eleboss/DJI_robomaster_car/README.md

# DJI_robomaster_car 
是为了参加DJI2017 robomaster竞赛中的地面机器人挑战赛而特地写的地面机器人控制程序。  
里头完成了一些例如SPI IIC CAN等总线的进本框架程序并且通过了测试  
进一步的，包含了位置式的串级PID  
还有一些杂资料
