eleboss/DJI_robomaster_car/Solidworks文件/ROBOmaster/底部接夹.SLDPRT

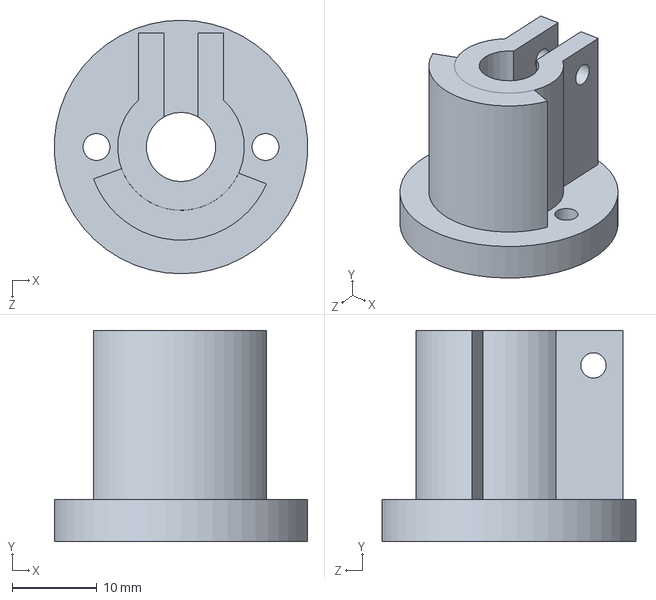
[picture p14: CAD file, 2017-07-21]
Solidworks文件/ROBOmaster/底部接夹.SLDPRT
29.9 x 25.0 x 30.0 mm
