eleboss/DJI_robomaster_car/Solidworks文件/ROBOmaster/holder.SLDPRT

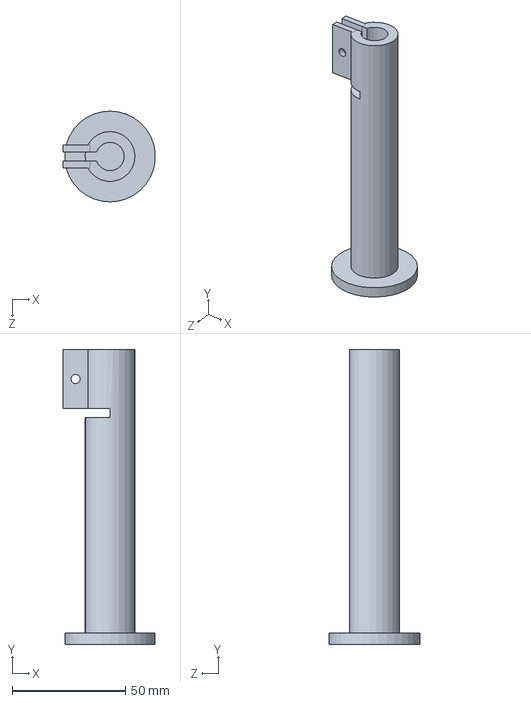
[picture p16: CAD file, 2017-07-15]
Solidworks文件/ROBOmaster/holder.SLDPRT
40.7 x 130.0 x 40.0 mm
