eleboss/DJI_robomaster_car/Solidworks文件/ROBOmaster/车车/新建文件夹 (4)/后方底盘竖杆2.SLDPRT

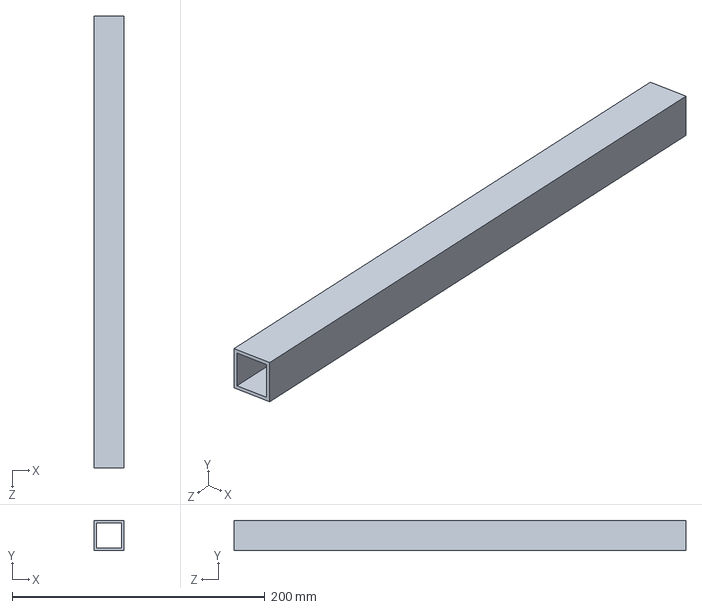
[picture p17: CAD file, 2017-07-21]
Solidworks文件/ROBOmaster/车车/新建文件夹 (4)/后方底盘竖杆2.SLDPRT
24.0 x 24.0 x 358.0 mm
