eleboss/DJI_robomaster_car/Solidworks文件/ROBOmaster/卡件.SLDPRT

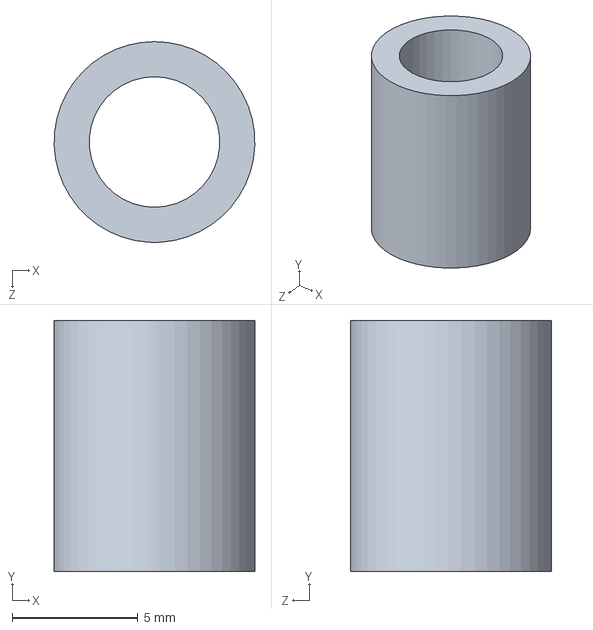
[picture p18: CAD file, 2017-07-15]
Solidworks文件/ROBOmaster/卡件.SLDPRT
8.00 x 10.0 x 8.00 mm
