eleboss/DJI_robomaster_car/Solidworks文件/ROBOmaster/车车/新建文件夹 (4)/导轨滑台与丝杆滑台连接片.SLDPRT

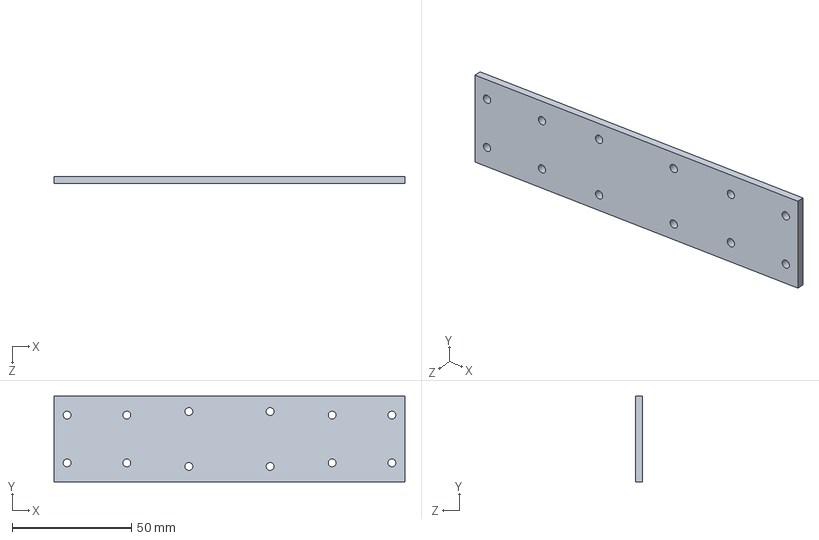
[picture p19: CAD file, 2017-07-21]
Solidworks文件/ROBOmaster/车车/新建文件夹 (4)/导轨滑台与丝杆滑台连接片.SLDPRT
147.0 x 36.0 x 3.00 mm
