eleboss/DJI_robomaster_car/Solidworks文件/ROBOmaster/比赛台子-3D printer.SLDPRT

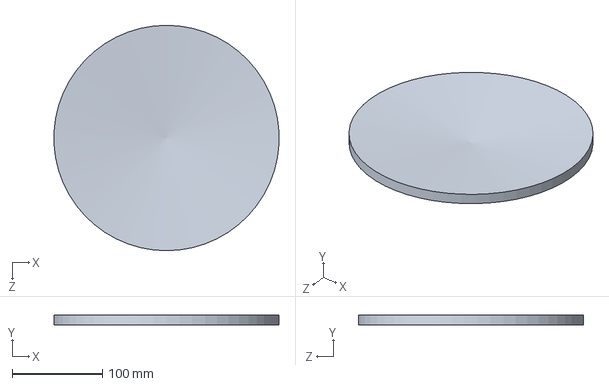
[picture p20: CAD file, 2017-07-10]
Solidworks文件/ROBOmaster/比赛台子-3D printer.SLDPRT
249.7 x 10.9 x 250.1 mm
