eleboss/DJI_robomaster_car/Solidworks文件/ROBOmaster/车车/新建文件夹 (4)/与57步进电机相连的板.SLDPRT

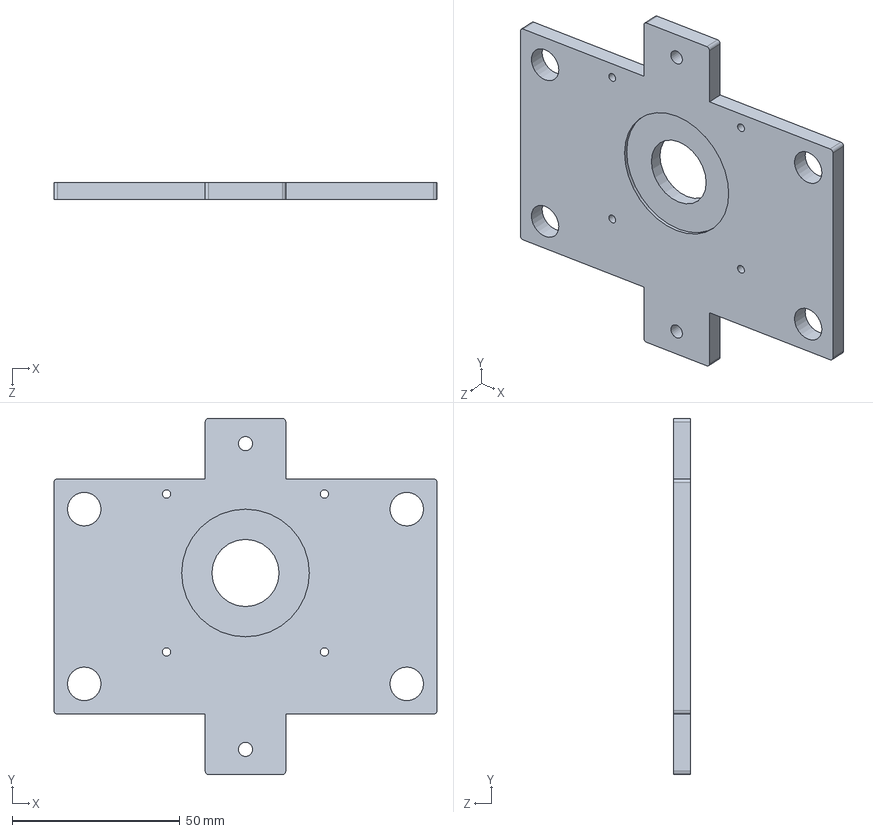
[picture p21: CAD file, 2017-07-21]
Solidworks文件/ROBOmaster/车车/新建文件夹 (4)/与57步进电机相连的板.SLDPRT
114.0 x 106.0 x 5.00 mm
