eleboss/DJI_robomaster_car/Solidworks文件/ROBOmaster/比赛台子-新.SLDPRT

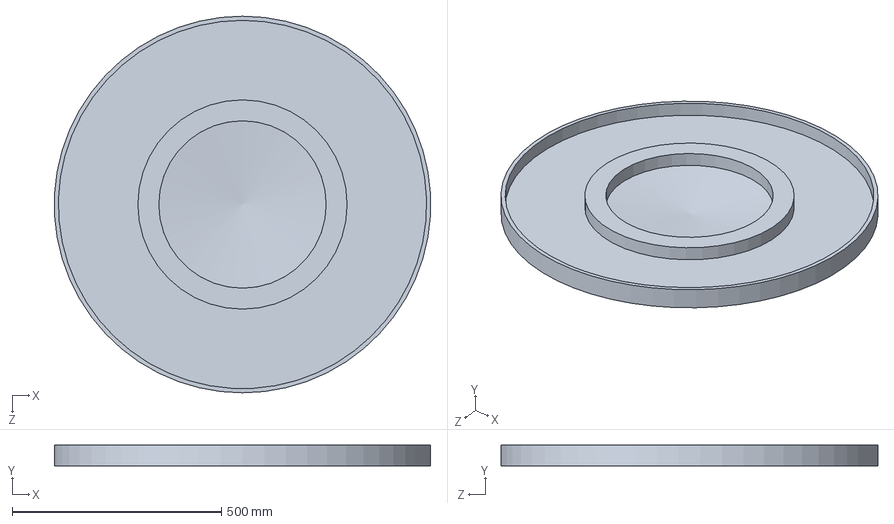
[picture p22: CAD file, 2017-07-10]
Solidworks文件/ROBOmaster/比赛台子-新.SLDPRT
898.5 x 50.0 x 900.0 mm
