eleboss/DJI_robomaster_car/Solidworks文件/ROBOmaster/车车/新建文件夹 (4)/车后方竖杆2.SLDPRT

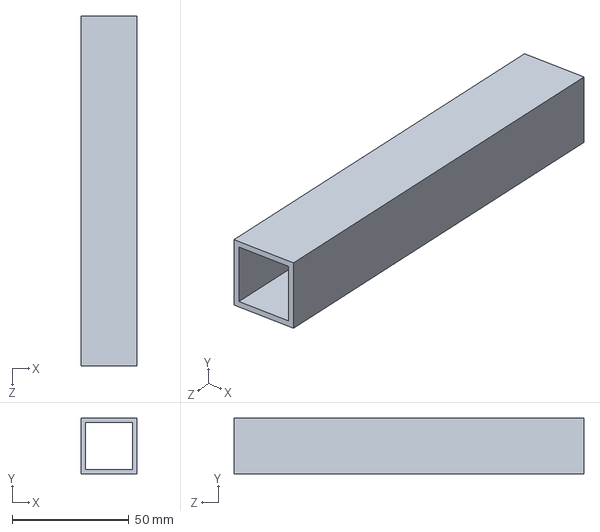
[picture p24: CAD file, 2017-07-21]
Solidworks文件/ROBOmaster/车车/新建文件夹 (4)/车后方竖杆2.SLDPRT
24.0 x 24.0 x 150.0 mm
