eleboss/DJI_robomaster_car/Solidworks文件/ROBOmaster/轴.SLDPRT

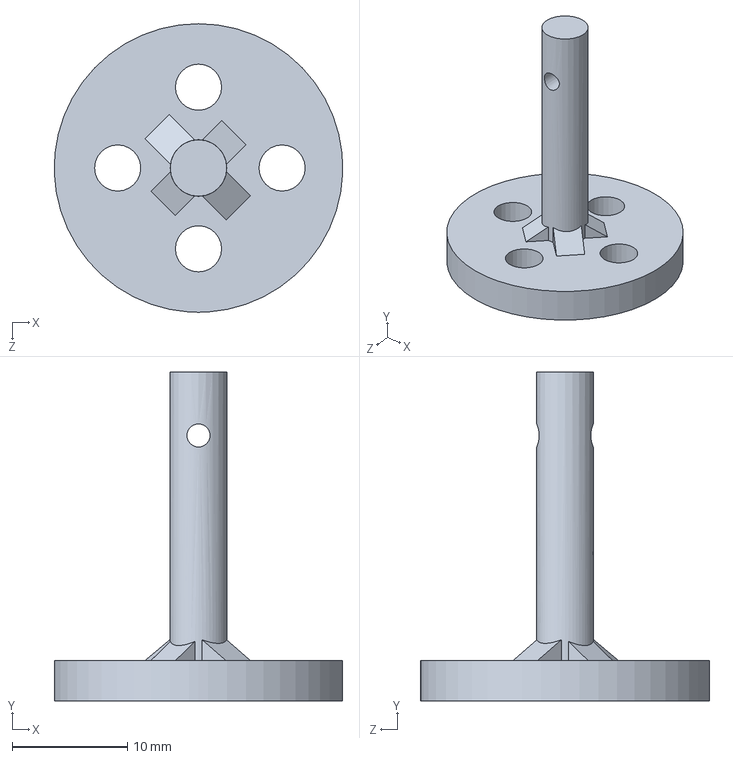
[picture p25: CAD file, 2017-07-10]
Solidworks文件/ROBOmaster/轴.SLDPRT
25.0 x 28.5 x 25.0 mm
