eleboss/DJI_robomaster_car/Solidworks文件/ROBOmaster/车车/新建文件夹 (4)/杆1.SLDPRT

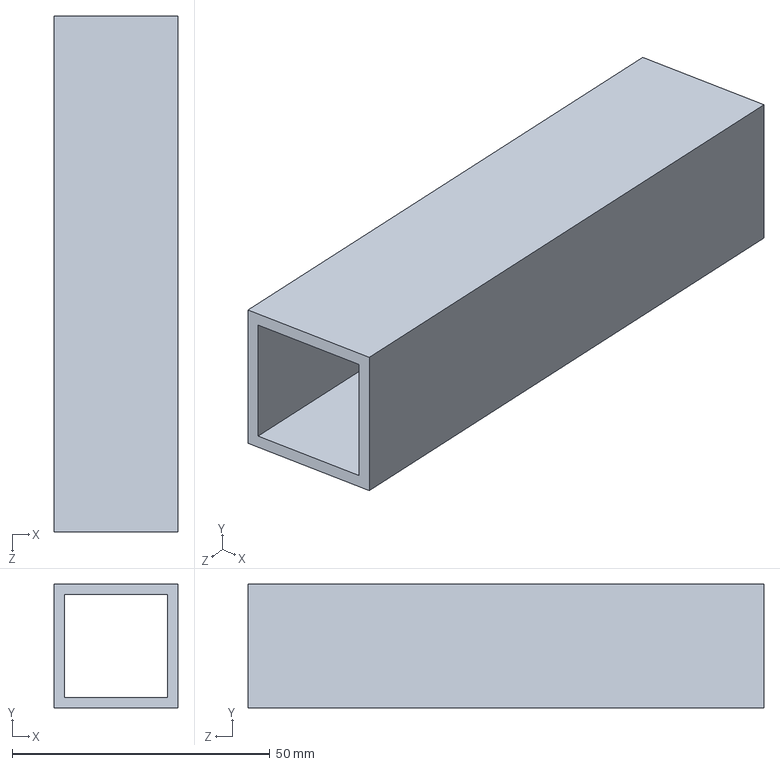
[picture p26: CAD file, 2017-07-21]
Solidworks文件/ROBOmaster/车车/新建文件夹 (4)/杆1.SLDPRT
24.0 x 24.0 x 100.0 mm
