eleboss/DJI_robomaster_car/Solidworks文件/ROBOmaster/车车/新建文件夹 (4)/丝杆底座BF.SLDPRT

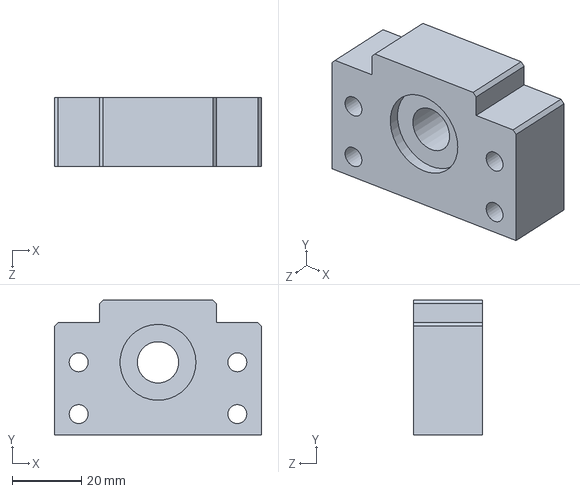
[picture p27: CAD file, 2017-07-21]
Solidworks文件/ROBOmaster/车车/新建文件夹 (4)/丝杆底座BF.SLDPRT
60.0 x 39.0 x 20.0 mm
