eleboss/DJI_robomaster_car/Solidworks文件/ROBOmaster/车车/新建文件夹 (4)/后方推板连接片.SLDPRT

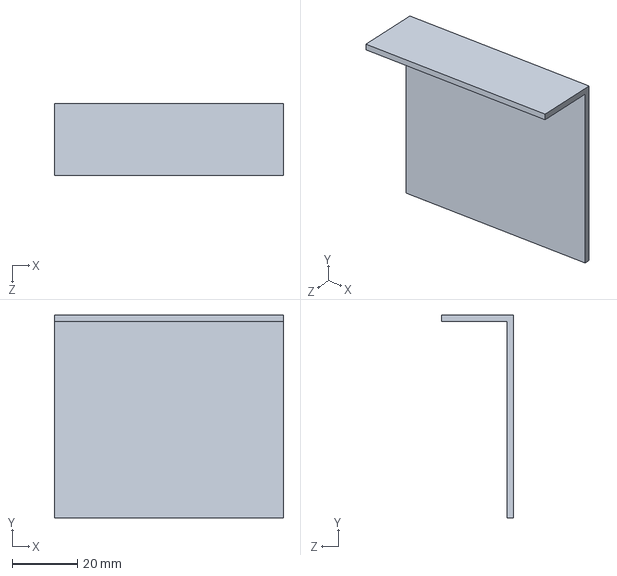
[picture p28: CAD file, 2017-07-21]
Solidworks文件/ROBOmaster/车车/新建文件夹 (4)/后方推板连接片.SLDPRT
70.0 x 62.0 x 22.0 mm
