eleboss/DJI_robomaster_car/Solidworks文件/ROBOmaster/车车/新建文件夹 (4)/车后轮竖杆.SLDPRT

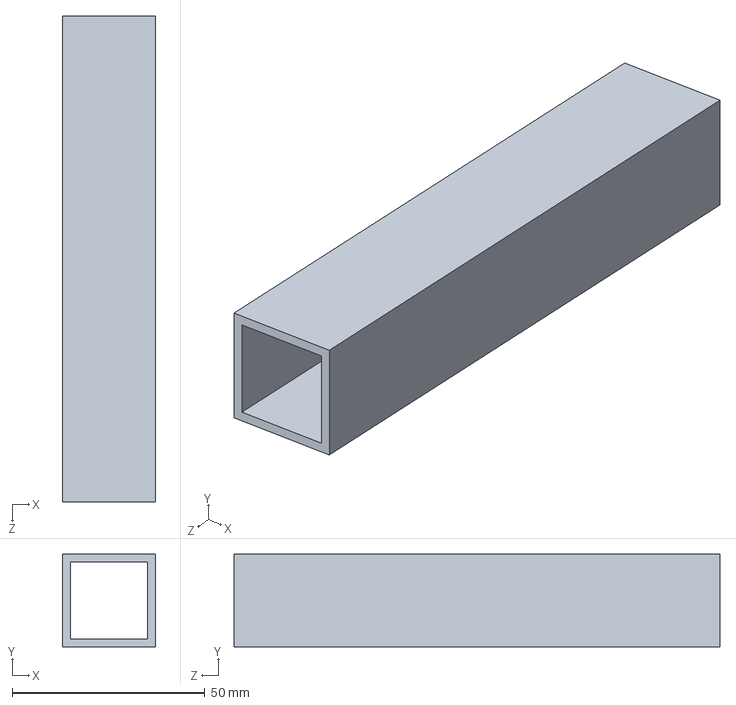
[picture p29: CAD file, 2017-07-21]
Solidworks文件/ROBOmaster/车车/新建文件夹 (4)/车后轮竖杆.SLDPRT
24.0 x 24.0 x 126.0 mm
