eleboss/DJI_robomaster_car/Solidworks文件/ROBOmaster/车车/新建文件夹 (4)/后轮连接片.SLDPRT

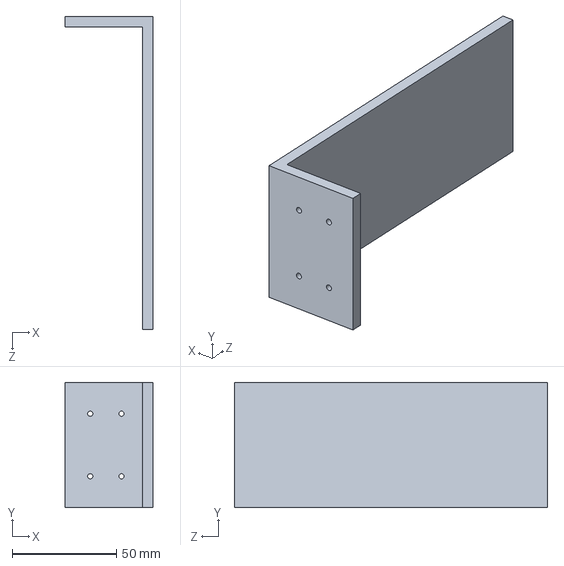
[picture p30: CAD file, 2017-07-21]
Solidworks文件/ROBOmaster/车车/新建文件夹 (4)/后轮连接片.SLDPRT
42.0 x 60.0 x 150.0 mm
