eleboss/DJI_robomaster_car/Solidworks文件/ROBOmaster/车车/新建文件夹 (4)/夹子支撑板.SLDPRT

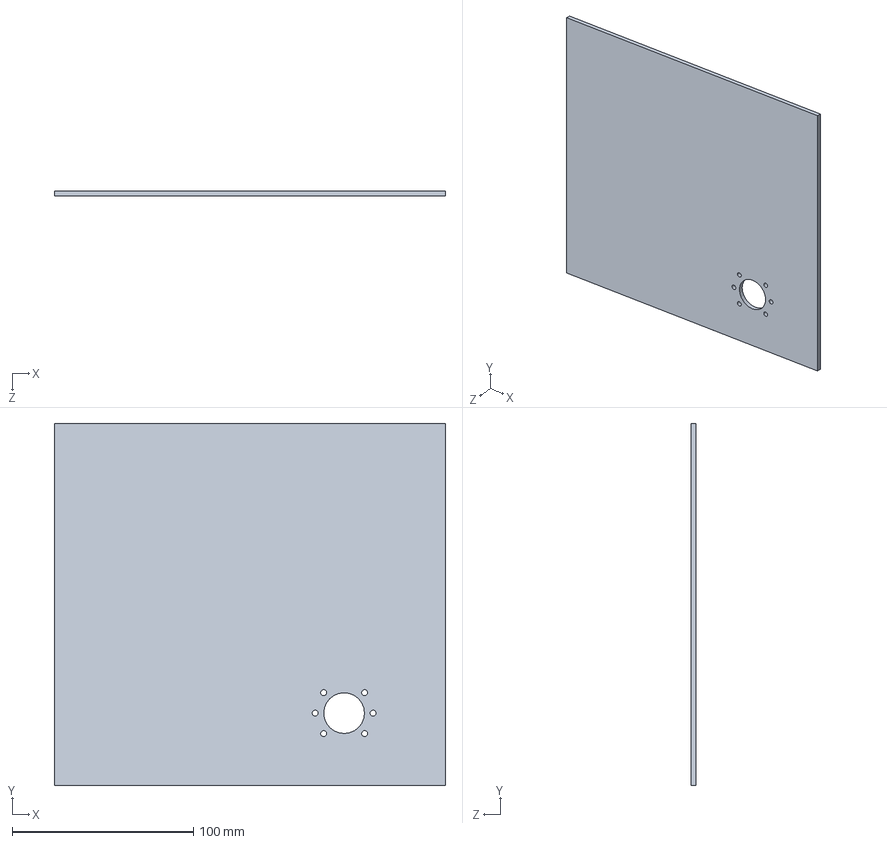
[picture p31: CAD file, 2017-07-21]
Solidworks文件/ROBOmaster/车车/新建文件夹 (4)/夹子支撑板.SLDPRT
216.0 x 200.0 x 3.00 mm
