eleboss/DJI_robomaster_car/Solidworks文件/ROBOmaster/车车/新建文件夹 (4)/导轨.SLDPRT

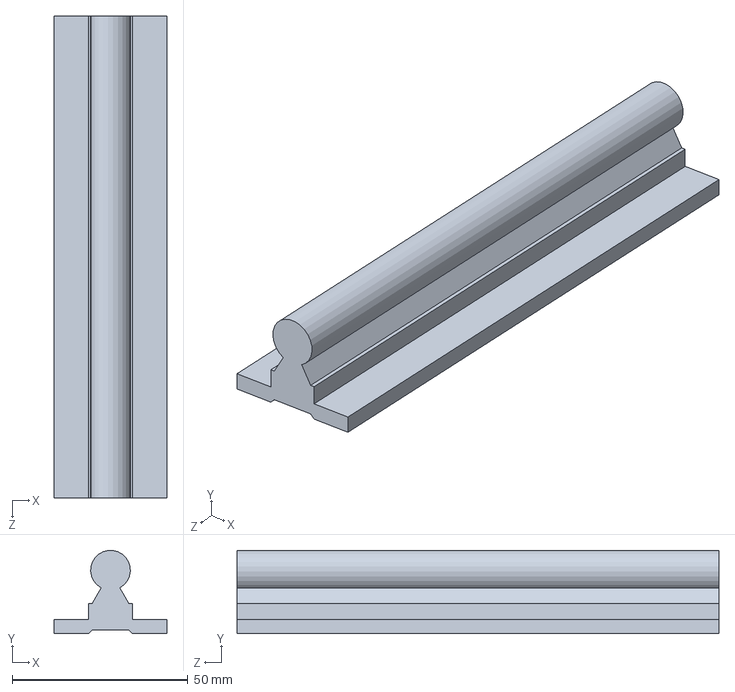
[picture p33: CAD file, 2017-07-21]
Solidworks文件/ROBOmaster/车车/新建文件夹 (4)/导轨.SLDPRT
32.0 x 23.6 x 137.0 mm
