eleboss/DJI_robomaster_car/Solidworks文件/ROBOmaster/车车/新建文件夹 (4)/支撑柱.SLDPRT

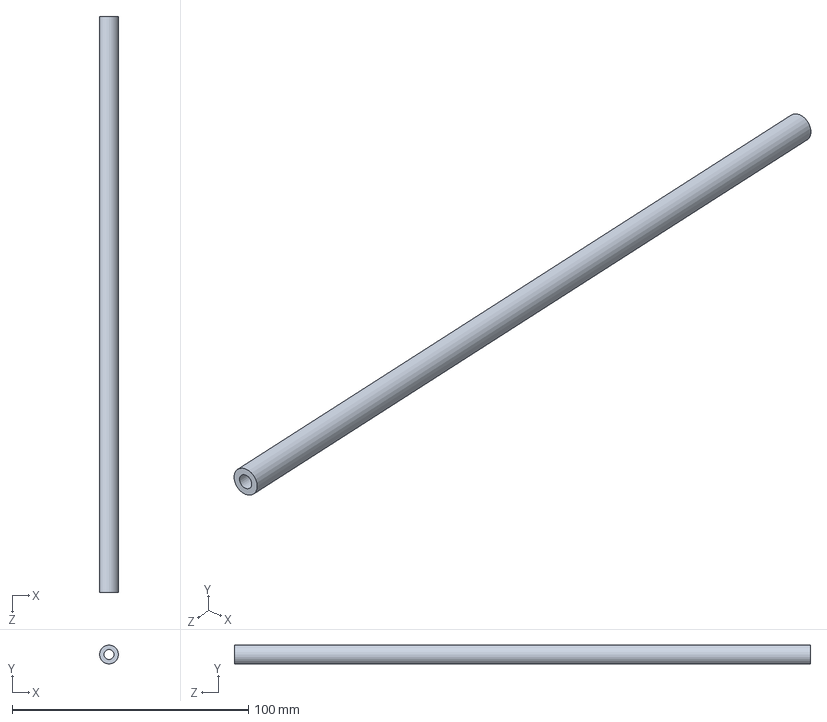
[picture p35: CAD file, 2017-07-21]
Solidworks文件/ROBOmaster/车车/新建文件夹 (4)/支撑柱.SLDPRT
8.00 x 8.00 x 243.9 mm
