eleboss/DJI_robomaster_car/Solidworks文件/ROBOmaster/车车/新建文件夹 (4)/与BK相连的竖杆.SLDPRT

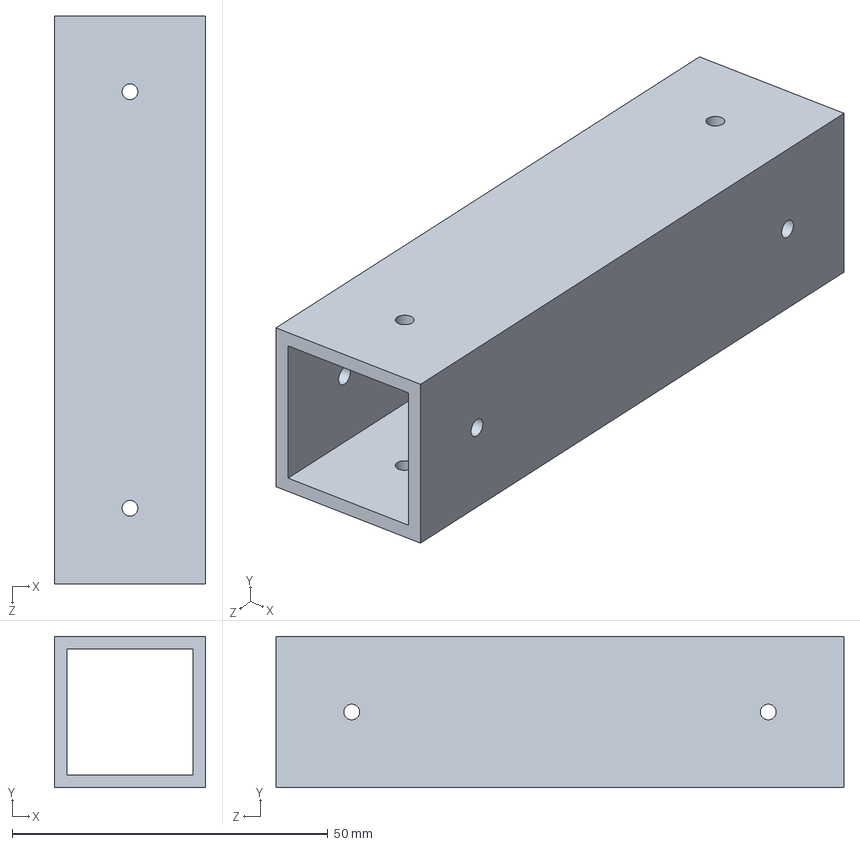
[picture p36: CAD file, 2017-07-21]
Solidworks文件/ROBOmaster/车车/新建文件夹 (4)/与BK相连的竖杆.SLDPRT
24.0 x 24.0 x 90.0 mm
