eleboss/DJI_robomaster_car/Solidworks文件/ROBOmaster/车车/新建文件夹 (4)/主竖杆.SLDPRT

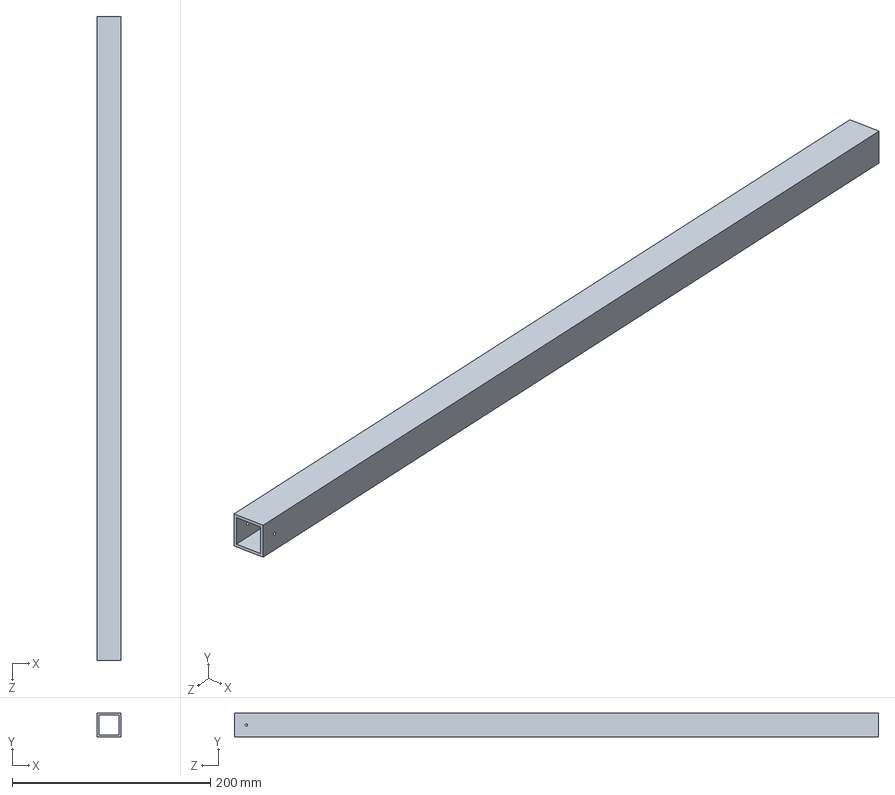
[picture p37: CAD file, 2017-07-21]
Solidworks文件/ROBOmaster/车车/新建文件夹 (4)/主竖杆.SLDPRT
24.0 x 24.0 x 650.0 mm
