eleboss/DJI_robomaster_car/Solidworks文件/ROBOmaster/车车/新建文件夹 (4)/丝杆4.SLDPRT

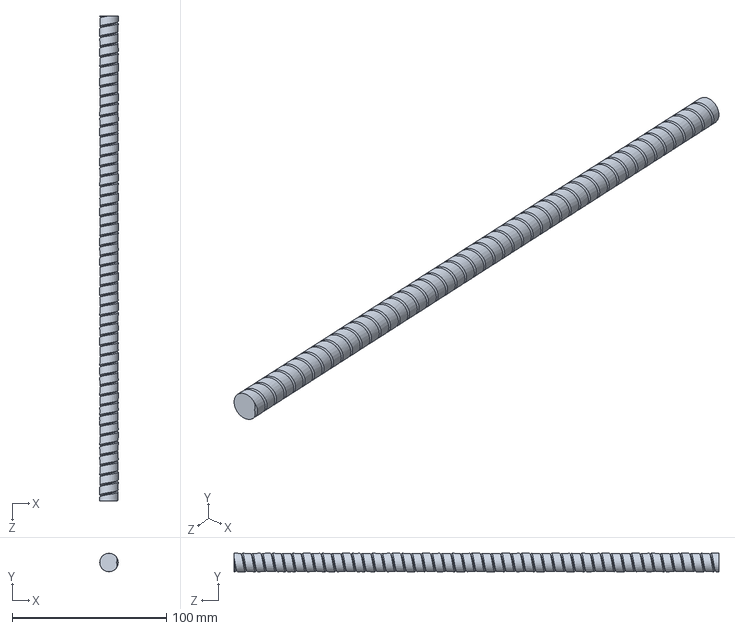
[picture p38: CAD file, 2017-07-21]
Solidworks文件/ROBOmaster/车车/新建文件夹 (4)/丝杆4.SLDPRT
12.0 x 12.0 x 314.0 mm
