eleboss/DJI_robomaster_car/Solidworks文件/ROBOmaster/车车/新建文件夹 (4)/与后轮马达相连杆.SLDPRT

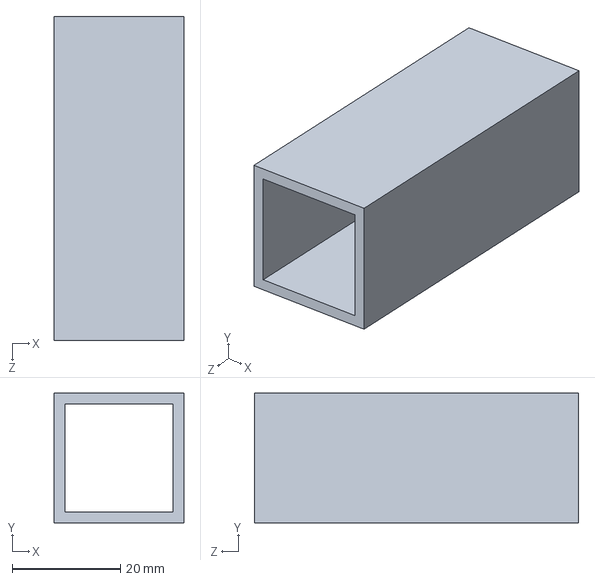
[picture p39: CAD file, 2017-07-21]
Solidworks文件/ROBOmaster/车车/新建文件夹 (4)/与后轮马达相连杆.SLDPRT
24.0 x 24.0 x 60.0 mm
