eleboss/DJI_robomaster_car/Solidworks文件/ROBOmaster/车车/新建文件夹 (4)/滑台连接座.SLDPRT

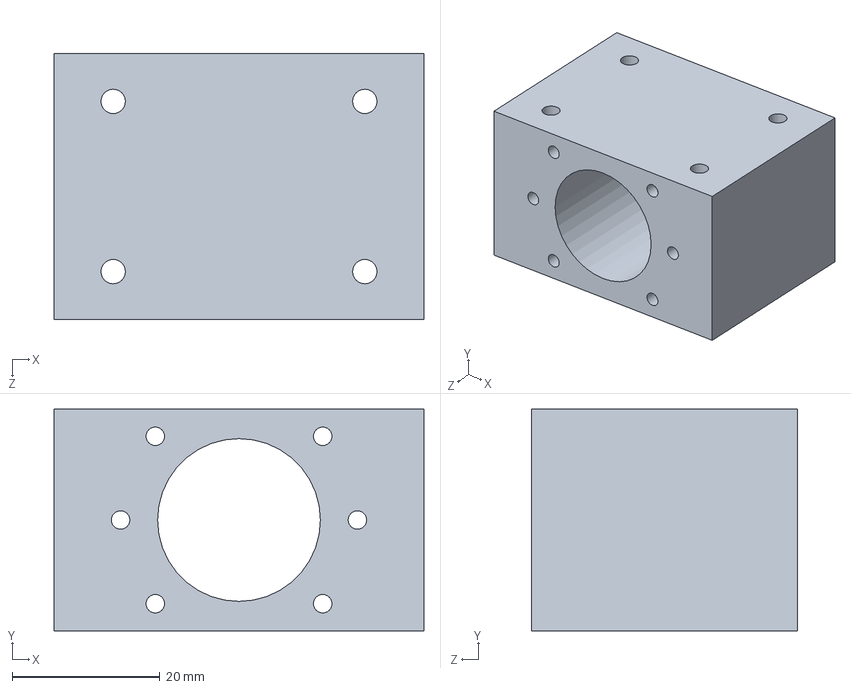
[picture p40: CAD file, 2017-07-21]
Solidworks文件/ROBOmaster/车车/新建文件夹 (4)/滑台连接座.SLDPRT
50.0 x 30.0 x 36.0 mm
