eleboss/DJI_robomaster_car/Solidworks文件/ROBOmaster/车车/新建文件夹 (4)/套筒.SLDPRT

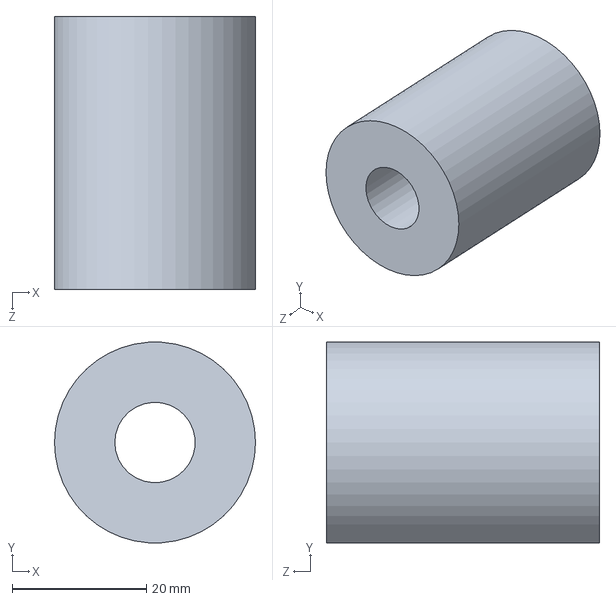
[picture p41: CAD file, 2017-07-21]
Solidworks文件/ROBOmaster/车车/新建文件夹 (4)/套筒.SLDPRT
30.0 x 29.9 x 40.8 mm
