eleboss/DJI_robomaster_car/Solidworks文件/ROBOmaster/车车/新建文件夹 (4)/上升横杆.SLDPRT

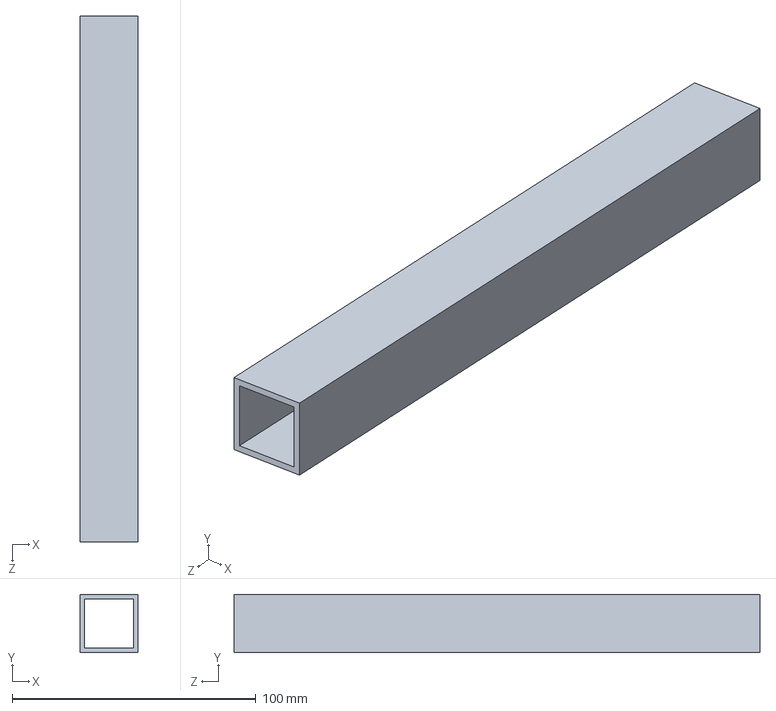
[picture p42: CAD file, 2017-07-21]
Solidworks文件/ROBOmaster/车车/新建文件夹 (4)/上升横杆.SLDPRT
24.0 x 24.0 x 216.0 mm
