eleboss/DJI_robomaster_car/Solidworks文件/ROBOmaster/车车/新建文件夹 (4)/夹子.SLDPRT

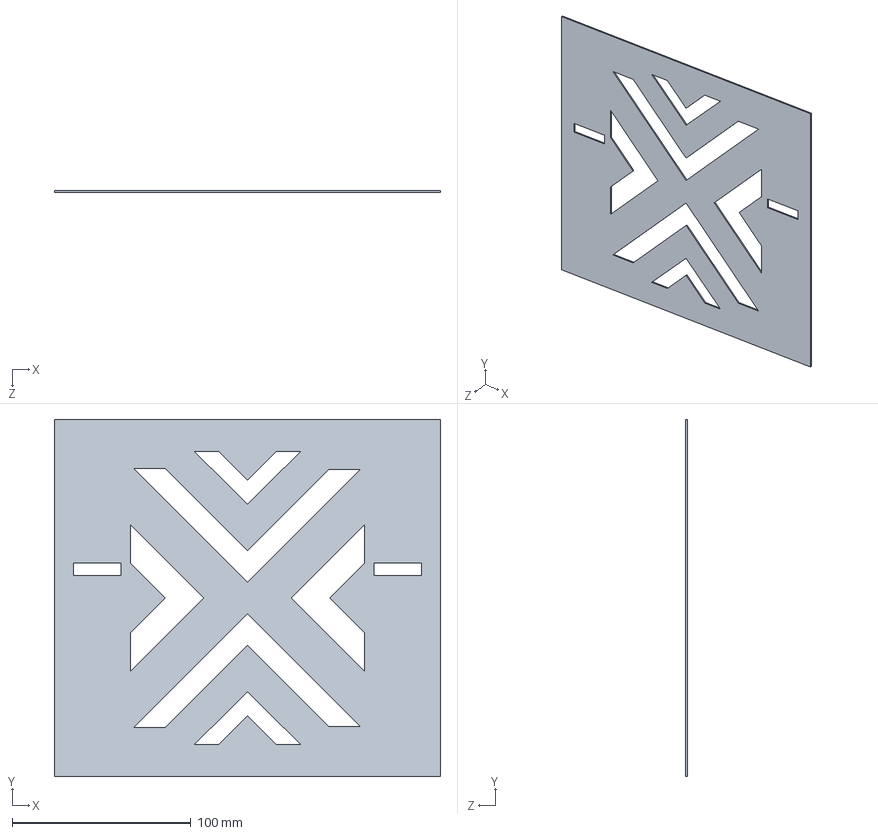
[picture p43: CAD file, 2017-07-21]
Solidworks文件/ROBOmaster/车车/新建文件夹 (4)/夹子.SLDPRT
216.0 x 200.0 x 1.00 mm
