eleboss/DJI_robomaster_car/Solidworks文件/ROBOmaster/车车/新建文件夹 (4)/丝杆2.SLDPRT

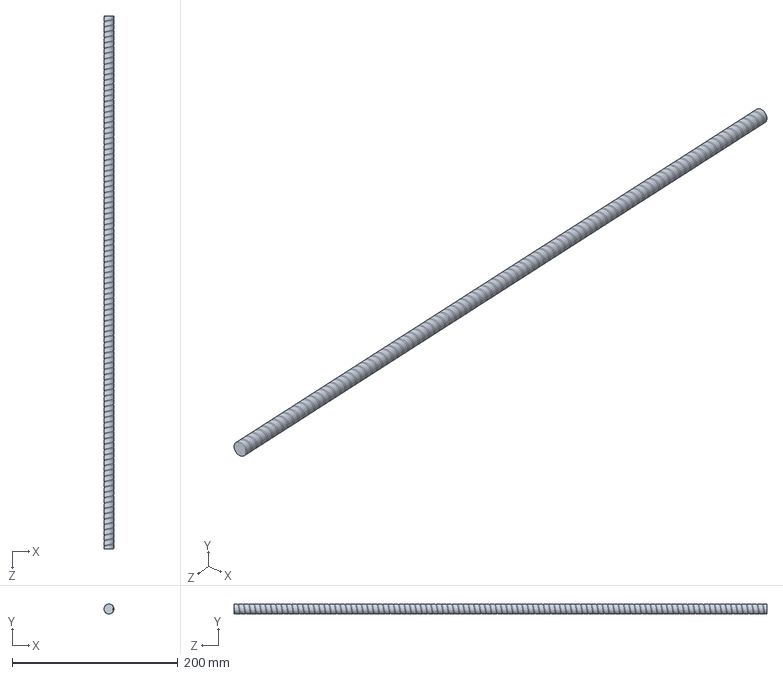
[picture p44: CAD file, 2017-07-21]
Solidworks文件/ROBOmaster/车车/新建文件夹 (4)/丝杆2.SLDPRT
12.0 x 12.0 x 643.0 mm
