eleboss/DJI_robomaster_car/Solidworks文件/ROBOmaster/车车/新建文件夹 (4)/夹子连接.SLDPRT

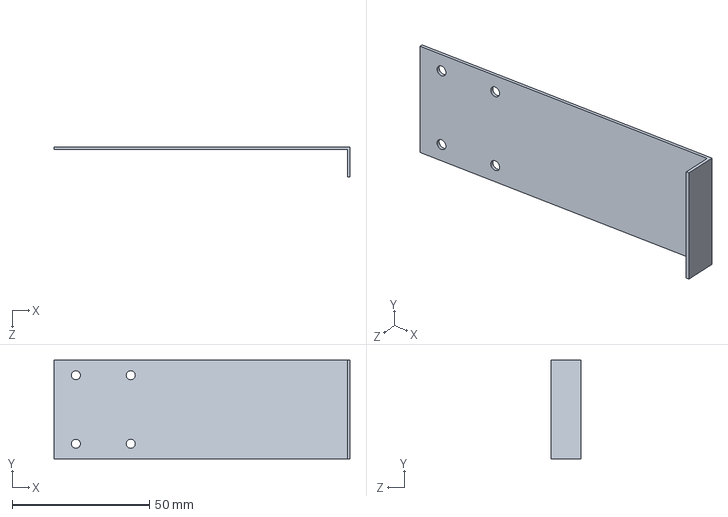
[picture p45: CAD file, 2017-07-21]
Solidworks文件/ROBOmaster/车车/新建文件夹 (4)/夹子连接.SLDPRT
108.0 x 36.0 x 11.0 mm
