eleboss/DJI_robomaster_car/Solidworks文件/ROBOmaster/车车/新建文件夹 (4)/滑台11.SLDPRT

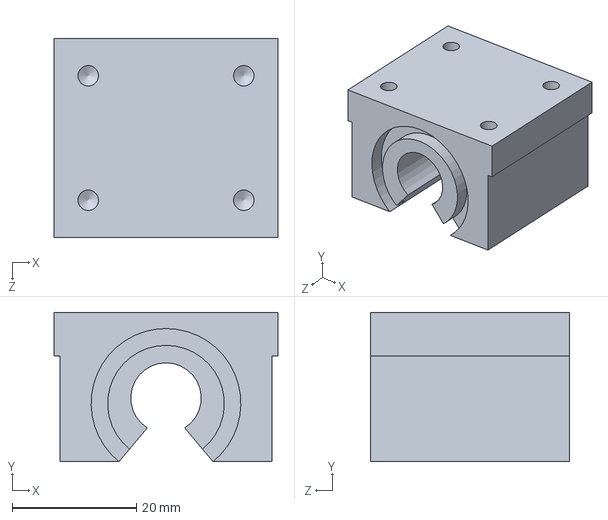
[picture p46: CAD file, 2017-07-21]
Solidworks文件/ROBOmaster/车车/新建文件夹 (4)/滑台11.SLDPRT
36.0 x 24.0 x 32.0 mm
