eleboss/DJI_robomaster_car/Solidworks文件/ROBOmaster/车车/新建文件夹 (4)/后方推板.SLDPRT

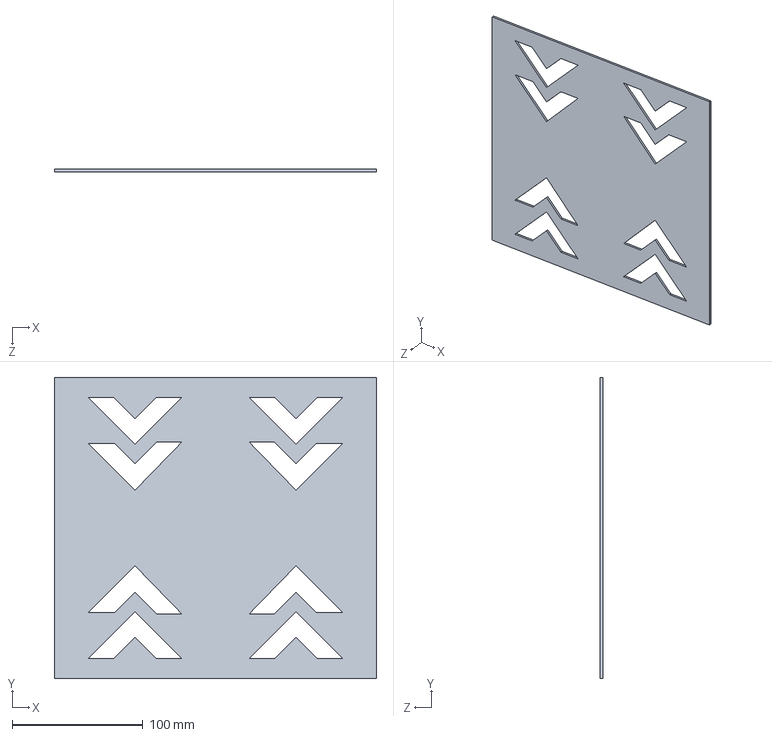
[picture p47: CAD file, 2017-07-21]
Solidworks文件/ROBOmaster/车车/新建文件夹 (4)/后方推板.SLDPRT
246.0 x 230.0 x 2.00 mm
