eleboss/DJI_robomaster_car/Solidworks文件/ROBOmaster/车车/新建文件夹 (4)/连接片.SLDPRT

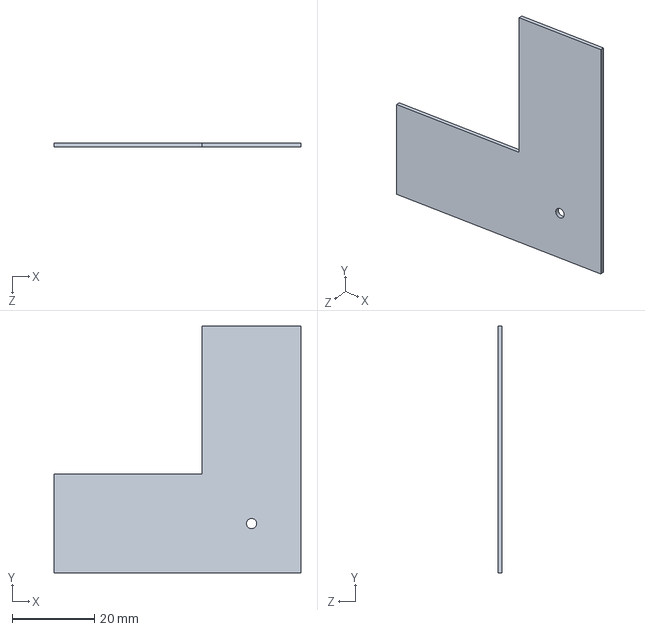
[picture p48: CAD file, 2017-07-21]
Solidworks文件/ROBOmaster/车车/新建文件夹 (4)/连接片.SLDPRT
60.0 x 60.0 x 1.00 mm
