eleboss/DJI_robomaster_car/Solidworks文件/ROBOmaster/车车/新建文件夹 (4)/滑台.SLDPRT

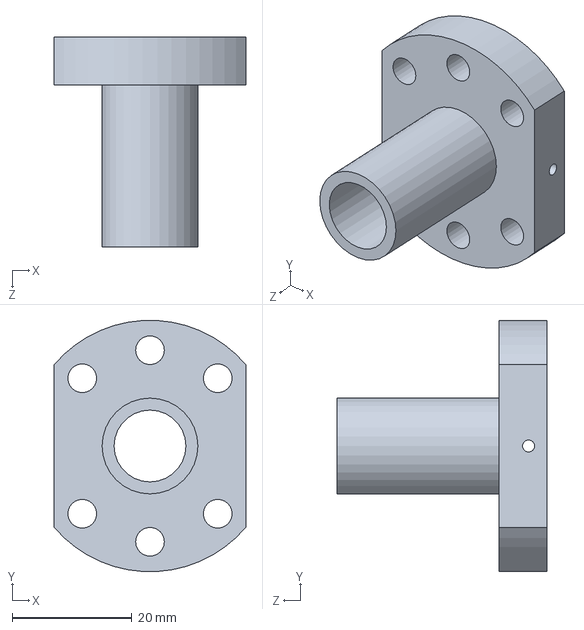
[picture p50: CAD file, 2017-07-21]
Solidworks文件/ROBOmaster/车车/新建文件夹 (4)/滑台.SLDPRT
32.0 x 41.9 x 35.0 mm
