eleboss/DJI_robomaster_car/Solidworks文件/ROBOmaster/车车/新建文件夹 (4)/铝圆柱杆.SLDPRT

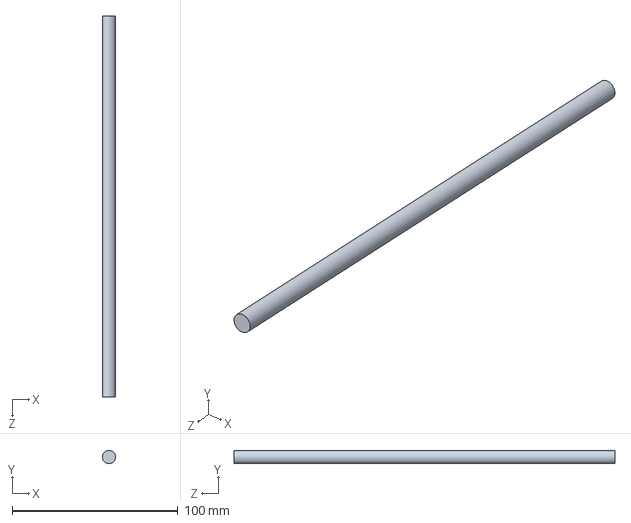
[picture p51: CAD file, 2017-07-21]
Solidworks文件/ROBOmaster/车车/新建文件夹 (4)/铝圆柱杆.SLDPRT
8.00 x 8.00 x 230.0 mm
