eleboss/DJI_robomaster_car/Solidworks文件/ROBOmaster/车车/新建文件夹 (4)/车后部盖板.SLDPRT

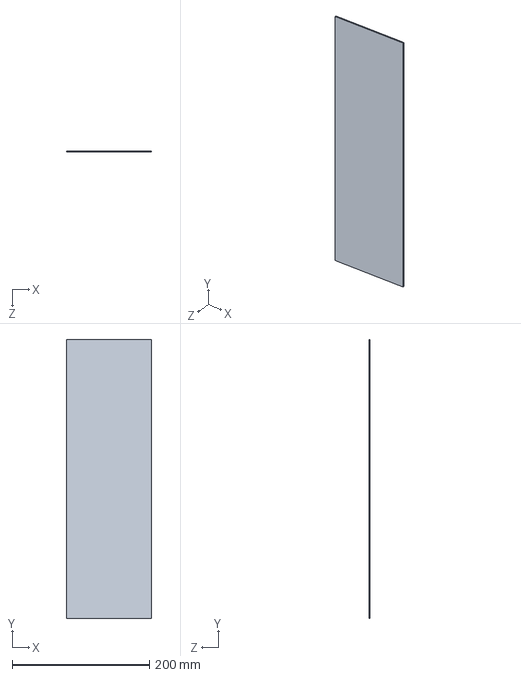
[picture p53: CAD file, 2017-07-21]
Solidworks文件/ROBOmaster/车车/新建文件夹 (4)/车后部盖板.SLDPRT
124.0 x 406.0 x 2.00 mm
