eleboss/DJI_robomaster_car/Solidworks文件/ROBOmaster/车车/新建文件夹 (4)/预备.SLDPRT

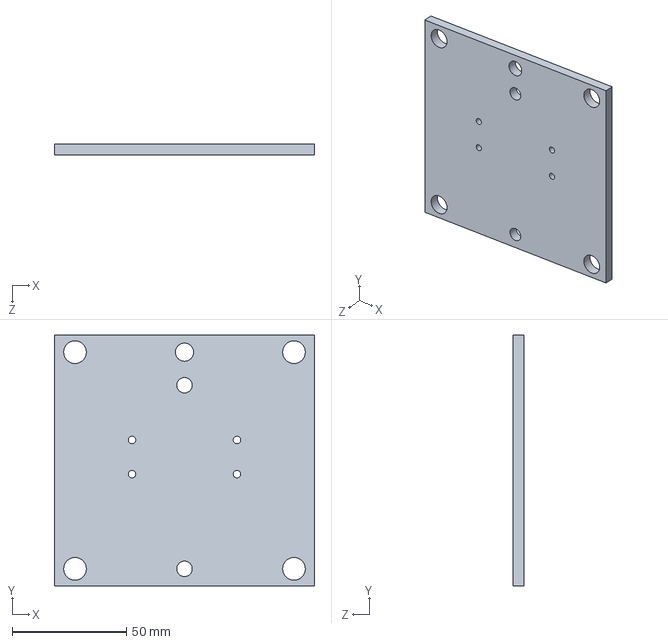
[picture p54: CAD file, 2017-07-21]
Solidworks文件/ROBOmaster/车车/新建文件夹 (4)/预备.SLDPRT
114.0 x 110.0 x 5.00 mm
