eleboss/DJI_robomaster_car/Solidworks文件/ROBOmaster/车车/新建文件夹 (4)/丝杆和电机相连固定座.SLDPRT

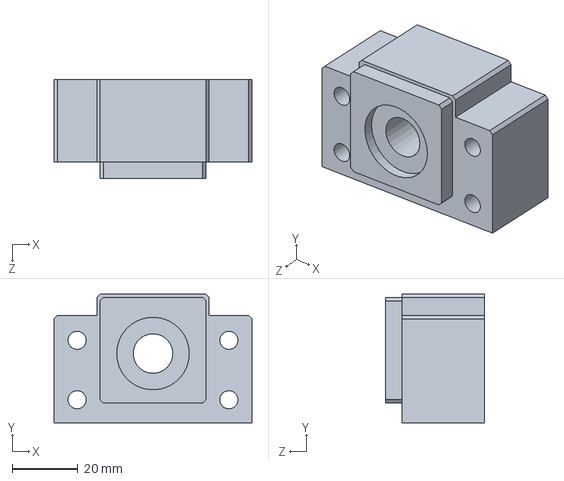
[picture p55: CAD file, 2017-07-21]
Solidworks文件/ROBOmaster/车车/新建文件夹 (4)/丝杆和电机相连固定座.SLDPRT
60.0 x 39.0 x 30.0 mm
