eleboss/DJI_robomaster_car/Solidworks文件/ROBOmaster/车车/新建文件夹 (4)/车后方底盘横杆.SLDPRT

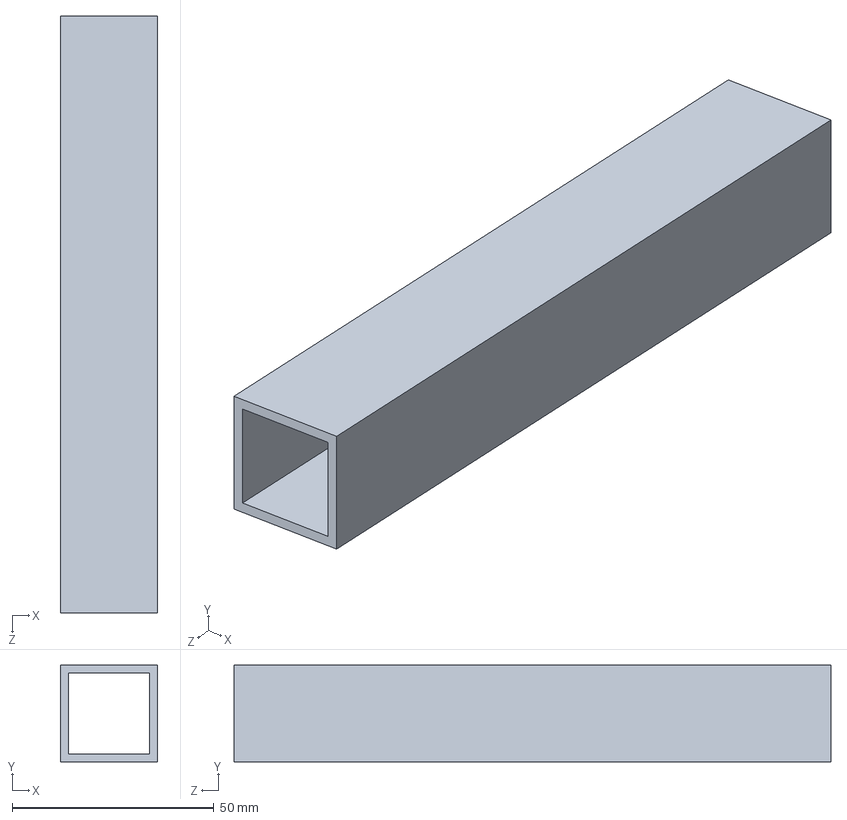
[picture p56: CAD file, 2017-07-21]
Solidworks文件/ROBOmaster/车车/新建文件夹 (4)/车后方底盘横杆.SLDPRT
24.0 x 24.0 x 148.0 mm
