eleboss/DJI_robomaster_car/Solidworks文件/ROBOmaster/车车/新建文件夹 (4)/与上升电机连接片.SLDPRT

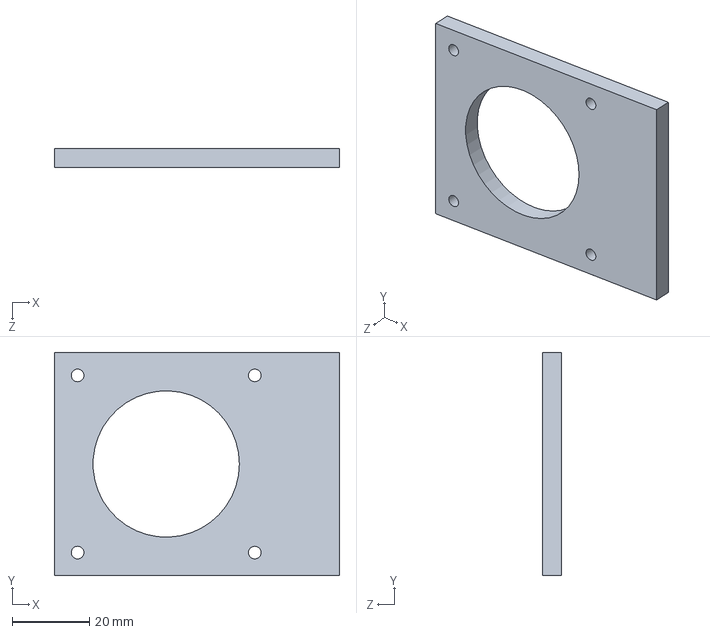
[picture p59: CAD file, 2017-07-21]
Solidworks文件/ROBOmaster/车车/新建文件夹 (4)/与上升电机连接片.SLDPRT
74.0 x 58.0 x 5.00 mm
