eleboss/DJI_robomaster_car/Solidworks文件/ROBOmaster/车车/新建文件夹 (4)/车后方竖杆.SLDPRT

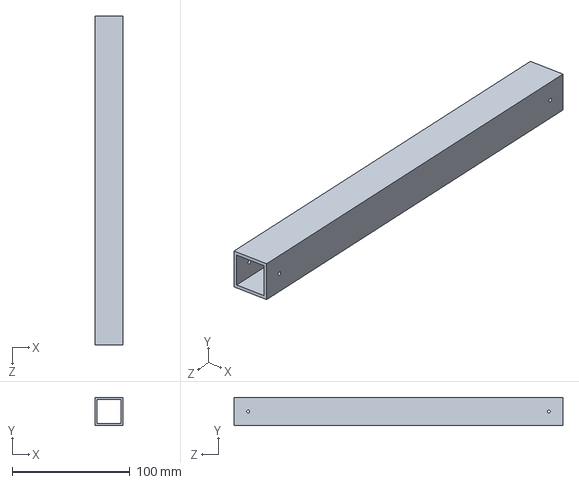
[picture p60: CAD file, 2017-07-21]
Solidworks文件/ROBOmaster/车车/新建文件夹 (4)/车后方竖杆.SLDPRT
24.0 x 24.0 x 279.0 mm
