eleboss/DJI_robomaster_car/Solidworks文件/ROBOmaster/车车/新建文件夹 (4)/后方丝杆连接片.SLDPRT

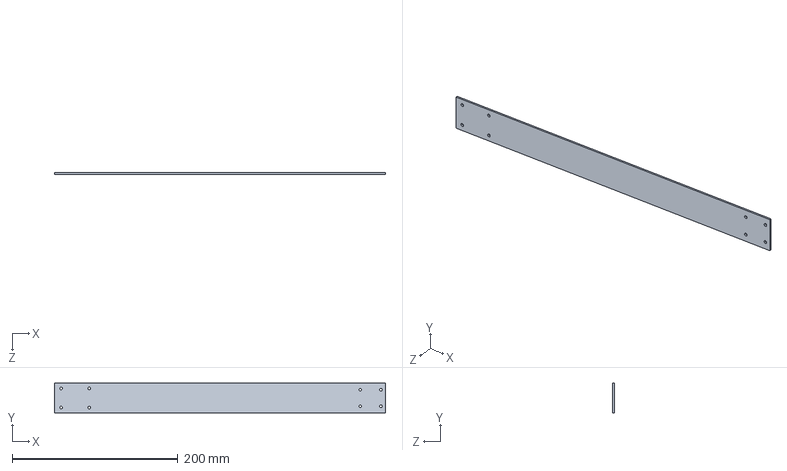
[picture p62: CAD file, 2017-07-21]
Solidworks文件/ROBOmaster/车车/新建文件夹 (4)/后方丝杆连接片.SLDPRT
400.0 x 36.0 x 2.00 mm
