eleboss/DJI_robomaster_car/(list of files, cad)

Other CAD files:
Solidworks文件/ROBOmaster/车车/新建文件夹 (4)/主横杆.SLDPRT
Solidworks文件/ROBOmaster/车车/新建文件夹 (4)/车前方横杆.SLDPRT
Solidworks文件/ROBOmaster/车车/新建文件夹 (4)/与BK相连的连接片.SLDPRT
Solidworks文件/ROBOmaster/车车/新建文件夹 (4)/与马达相关联板.SLDPRT
Solidworks文件/ROBOmaster/车车/新建文件夹 (4)/底座连接片.SLDPRT
Solidworks文件/ROBOmaster/车车/新建文件夹 (4)/台.SLDDRW
Solidworks文件/ROBOmaster/车车/新建文件夹 (4)/预备.SLDDRW
