eleboss/DJI_robomaster_car/开源参考/2组嵌入式软件/夏令营 STM32/锯条v2/Mylib/control.h

#ifndef __CONTROL_H__
#define __CONTROL_H__

#define SWITCH GPIO_ReadInputDataBit(GPIOA, GPIO_Pin_1)

typedef struct AUTOCONTROL{
	unsigned char Catch;
}AUTOCONTROL;

void SWITCH_Configuration(void);
void AutoControl_Init(void);
void RCControl_Init(void);

#endif
