eleboss/DJI_robomaster_car/开源参考/RM2016_INFANTRY_OPEN_SOURCEV.1.6.4/BSP/encoder.c

#include "main.h"

//encoder.INPUT_B---PB4(TIM3_CH1)
//encoder.INPUT_A---PB5(TIM3_CH2)

void Quad_Encoder_Configuration(void)
{
	GPIO_InitTypeDef gpio;

	RCC_AHB1PeriphClockCmd(RCC_AHB1Periph_GPIOB, ENABLE);
  RCC_APB1PeriphClockCmd(RCC_APB1Periph_TIM3, ENABLE);

	gpio.GPIO_Pin = GPIO_Pin_5 | GPIO_Pin_4;
  gpio.GPIO_Speed = GPIO_Speed_100MHz;
	gpio.GPIO_Mode = GPIO_Mode_AF;
	gpio.GPIO_PuPd = GPIO_PuPd_UP;
	GPIO_Init(GPIOB,&gpio);
	
	GPIO_PinAFConfig(GPIOB,GPIO_PinSource5,GPIO_AF_TIM3);
	GPIO_PinAFConfig(GPIOB,GPIO_PinSource4,GPIO_AF_TIM3);
  TIM_EncoderInterfaceConfig(TIM3, TIM_EncoderMode_TI12, TIM_ICPolarity_Falling, TIM_ICPolarity_Falling);
  TIM_Cmd(TIM3,ENABLE);	 
}

void Encoder_Start(void)
{
    TIM3->CNT = 0x7fff;
}

static char Encoder_Dir = 0;
  
int32_t GetQuadEncoderDiff(void)
{
    int32_t cnt = 0;    
    cnt = (TIM3->CNT)-0x7fff;
    TIM3->CNT = 0x7fff;    
    if(Encoder_Dir == 1)
	{
		return cnt;	
	}
	else
	{
		return -cnt;            
	}
}
