eleboss/DJI_robomaster_car/开源参考/2组嵌入式软件/夏令营 STM32/步兵主控v6/Mylib/usart2.c

#include "main.h"

unsigned char RZigBee[RZigBeePackSize];
unsigned char TZigBee[TZigBeePackSize];
extern unsigned char TB[TBPackSize];

void USART2_Configuration(void)
{
    USART_InitTypeDef usart2;
		GPIO_InitTypeDef  gpio;
    NVIC_InitTypeDef  nvic;
	
		RCC_AHB1PeriphClockCmd(RCC_AHB1Periph_GPIOA,ENABLE);
		RCC_APB1PeriphClockCmd(RCC_APB1Periph_USART2,ENABLE);
	
		GPIO_PinAFConfig(GPIOA,GPIO_PinSource2,GPIO_AF_USART2);
		GPIO_PinAFConfig(GPIOA,GPIO_PinSource3,GPIO_AF_USART2); 
	
		gpio.GPIO_Pin = GPIO_Pin_2 | GPIO_Pin_3;
		gpio.GPIO_Mode = GPIO_Mode_AF;
    gpio.GPIO_OType = GPIO_OType_PP;
    gpio.GPIO_Speed = GPIO_Speed_50MHz;
    gpio.GPIO_PuPd = GPIO_PuPd_NOPULL;
		GPIO_Init(GPIOA,&gpio);

		usart2.USART_BaudRate = 115200;
		usart2.USART_WordLength = USART_WordLength_8b;
		usart2.USART_StopBits = USART_StopBits_1;
		usart2.USART_Parity = USART_Parity_No;
		usart2.USART_Mode = USART_Mode_Tx|USART_Mode_Rx;
    usart2.USART_HardwareFlowControl = USART_HardwareFlowControl_None;
		USART_Init(USART2,&usart2);
		USART_Cmd(USART2,ENABLE);
		USART_DMACmd(USART2,USART_DMAReq_Rx|USART_DMAReq_Tx,ENABLE);
		
		nvic.NVIC_IRQChannel = DMA1_Stream5_IRQn;
		nvic.NVIC_IRQChannelPreemptionPriority = 3;
		nvic.NVIC_IRQChannelSubPriority = 2;
		nvic.NVIC_IRQChannelCmd = ENABLE;
		NVIC_Init(&nvic);
		
		nvic.NVIC_IRQChannel = DMA1_Stream6_IRQn;
		nvic.NVIC_IRQChannelPreemptionPriority = 3;
		nvic.NVIC_IRQChannelSubPriority = 2;
		nvic.NVIC_IRQChannelCmd = ENABLE;
		NVIC_Init(&nvic);
		
		{
			DMA_InitTypeDef 	dma;
			RCC_AHB1PeriphClockCmd(RCC_AHB1Periph_DMA1,ENABLE);
			//Tx
			dma.DMA_Channel= DMA_Channel_4;
			dma.DMA_PeripheralBaseAddr = (uint32_t)(&USART2->DR); 
			dma.DMA_Memory0BaseAddr = (uint32_t)TB;
			dma.DMA_DIR = DMA_DIR_MemoryToPeripheral;  
			dma.DMA_BufferSize = TBPackSize; 
			dma.DMA_PeripheralInc = DMA_PeripheralInc_Disable;
			dma.DMA_MemoryInc = DMA_MemoryInc_Enable;
			dma.DMA_PeripheralDataSize = DMA_PeripheralDataSize_Byte;
			dma.DMA_MemoryDataSize = DMA_PeripheralDataSize_Byte;
			dma.DMA_Mode = DMA_Mode_Circular;
			dma.DMA_Priority = DMA_Priority_Low;
			dma.DMA_FIFOMode = DMA_FIFOMode_Disable;
			dma.DMA_FIFOThreshold = DMA_FIFOThreshold_1QuarterFull;
			dma.DMA_MemoryBurst = DMA_Mode_Normal;
			dma.DMA_PeripheralBurst = DMA_PeripheralBurst_Single;
			DMA_Init(DMA1_Stream6,&dma);
			DMA_Cmd(DMA1_Stream6,ENABLE);
			
			//Rx
			dma.DMA_Channel= DMA_Channel_4;
			dma.DMA_PeripheralBaseAddr = (uint32_t)&(USART2->DR);
			dma.DMA_Memory0BaseAddr = (uint32_t)RZigBee;
			dma.DMA_DIR = DMA_DIR_PeripheralToMemory;
			dma.DMA_BufferSize = RZigBeePackSize;
			dma.DMA_PeripheralInc = DMA_PeripheralInc_Disable;
			dma.DMA_MemoryInc = DMA_MemoryInc_Enable;
			dma.DMA_PeripheralDataSize = DMA_PeripheralDataSize_Byte;
			dma.DMA_MemoryDataSize = DMA_MemoryDataSize_Byte;
			dma.DMA_Mode = DMA_Mode_Circular;
			dma.DMA_Priority = DMA_Priority_VeryHigh;
			dma.DMA_FIFOMode = DMA_FIFOMode_Disable;
			dma.DMA_FIFOThreshold = DMA_FIFOThreshold_1QuarterFull;
			dma.DMA_MemoryBurst = DMA_Mode_Normal;
			dma.DMA_PeripheralBurst = DMA_PeripheralBurst_Single;
			DMA_Init(DMA1_Stream5,&dma);
			DMA_Cmd(DMA1_Stream5,ENABLE);
			DMA_ITConfig(DMA1_Stream5,DMA_IT_TC,ENABLE);
	 }
}


void DMA1_Stream5_IRQHandler(void)
{
	int PackPoint = 0;
	if(DMA_GetITStatus(DMA1_Stream5, DMA_IT_TCIF5))
	{
		DMA_ClearFlag(DMA1_Stream5, DMA_FLAG_TCIF5);
		DMA_ClearITPendingBit(DMA1_Stream5, DMA_IT_TCIF5);
		for(PackPoint = 0; PackPoint < RBPackSize; PackPoint++)
		{
			if((RZigBee[PackPoint%RZigBeePackSize] == 'l')&&(RZigBee[(PackPoint+RZigBeePackSize-1)%RZigBeePackSize] == 'd'))
			{
				return;
			}
		}
	}		
}


void DMA1_Stream6_IRQHandler(void)
{
	if(DMA_GetITStatus(DMA1_Stream6, DMA_IT_TCIF6))
	{
		DMA_ClearFlag(DMA1_Stream6, DMA_FLAG_TCIF6);
		DMA_ClearITPendingBit(DMA1_Stream6, DMA_IT_TCIF6);
	}
}
