eleboss/DJI_robomaster_car/开源参考/icra2017rm-mmc-emb-release/app/inc/sys.h

/**
 * Copyright (c) 2011-2016, Jack Mo (mobangjack@foxmail.com).
 *
 * Licensed under the Apache License, Version 2.0 (the "License");
 * you may not use this file except in compliance with the License.
 * You may obtain a copy of the License at
 *
 *      http://www.apache.org/licenses/LICENSE-2.0
 *
 * Unless required by applicable law or agreed to in writing, software
 * distributed under the License is distributed on an "AS IS" BASIS,
 * WITHOUT WARRANTIES OR CONDITIONS OF ANY KIND, either express or implied.
 * See the License for the specific language governing permissions and
 * limitations under the License.
 */

#ifndef __SYS_H__
#define __SYS_H__

#ifdef __cplusplus
extern "C" {
#endif

#include <stdint.h>

#include "fun.h"

#define SYS_CTL_TMS 1 // ms
#define SYS_CTL_TSC 1e-3f // s

typedef uint32_t PeriphsState_t; // Peripherals state flag bits

#define FS_KEY_H        (((uint32_t)1u)<<0)
#define FS_KEY_L        (((uint32_t)1u)<<1)
#define FS_KEY_M        (((uint32_t)1u)<<2)
#define FS_KEY_N        (((uint32_t)1u)<<3)
#define FS_LED_RED      (((uint32_t)1u)<<4)
#define FS_LED_GREEN    (((uint32_t)1u)<<5)

#define FS_ALL      		(FS_KEY_H|FS_KEY_L|FS_KEY_M|FS_LED_RED|FS_LED_GREEN)
#define FS_NON       		((uint32_t)0)

typedef struct
{
	float x;
	float y;
	float z;
}ChassisState_t;

typedef struct
{
	float w1;
	float w2;
	float w3;
	float w4;
}MecanumState_t;

typedef struct
{
	float e;
	float c;
}GrabberState_t;

PeriphsState_t FS_Get(const PeriphsState_t* fs, PeriphsState_t mask);
void FS_Set(PeriphsState_t* fs, PeriphsState_t mask);
void FS_Clr(PeriphsState_t* fs, PeriphsState_t mask);
void FS_Tog(PeriphsState_t* fs, PeriphsState_t mask);
void FS_Cpy(PeriphsState_t* fs, PeriphsState_t src, PeriphsState_t mask);
void FS_Det(PeriphsState_t* fs, Flag_t mask, uint32_t condition);

void CS_Set(ChassisState_t* cs, float x, float y, float z);
void MS_Set(MecanumState_t* ms, float w1, float w2, float w3, float w4);
void GS_Set(GrabberState_t* gs, float e, float c);

#ifdef __cplusplus
}
#endif

#endif
