eleboss/DJI_robomaster_car/开源参考/icra2017rm-mmc-emb-release/asp/src/fun.c

/**
 * Copyright (c) 2011-2016, Jack Mo (mobangjack@foxmail.com).
 *
 * Licensed under the Apache License, Version 2.0 (the "License");
 * you may not use this file except in compliance with the License.
 * You may obtain a copy of the License at
 *
 *      http://www.apache.org/licenses/LICENSE-2.0
 *
 * Unless required by applicable law or agreed to in writing, software
 * distributed under the License is distributed on an "AS IS" BASIS,
 * WITHOUT WARRANTIES OR CONDITIONS OF ANY KIND, either express or implied.
 * See the License for the specific language governing permissions and
 * limitations under the License.
 */

#include "fun.h"

/******************************************************/
/*                  Helper Functions                  */
/******************************************************/

float min(float v1, float v2)
{
	return v1 < v2 ? v1 : v2;
}

float max(float v1, float v2)
{
	return v1 > v2 ? v1 : v2;
}

float map(float val, float min1, float max1, float min2, float max2)
{
	LIMIT(val, min1, max1);
	return ((val-min1)*(max2-min2)/(max1-min1)+min2);
}

float constrain(float val, float min, float max)
{
	return val < min ? min : val > max ? max : val;
}

Flag_t Flag_Get(const Flag_t* flag, Flag_t mask)
{
	return (*flag) & mask;
}

Flag_t Flag_Hit(const Flag_t* flag, Flag_t mask)
{
	return (((*flag) & mask) == mask);
}

void Flag_Set(Flag_t* flag, Flag_t mask)
{
	(*flag) |= mask;
}

void Flag_Clr(Flag_t* flag, Flag_t mask)
{
	(*flag) &= ~mask;
}

void Flag_Tog(Flag_t* flag, Flag_t mask)
{
	Flag_Get(flag, mask) ? Flag_Clr(flag, mask) : Flag_Set(flag, mask);
}

void Flag_Cpy(Flag_t* flag, Flag_t src, Flag_t mask)
{
	uint8_t n = sizeof(Flag_t) * 8;
	uint8_t i = 0;
	Flag_t tmp = 0;
	for (; i < n; i++) {
		tmp =  (((uint32_t)0x01) << i) & mask;
		if (Flag_Get(flag, tmp)) {
			Flag_Set(flag, tmp);
		} else {
			Flag_Clr(flag, tmp);
		}
	}
}

void Flag_Det(Flag_t* flag, Flag_t mask, uint32_t condition)
{
	if (condition) {
		Flag_Set(flag, mask);
	} else {
		Flag_Clr(flag, mask);
	}
}
