eleboss/DJI_robomaster_car/开源参考/2组嵌入式软件/夏令营 STM32/步兵主控v6/Mylib/usart4.h

#ifndef __USART4_H__
#define __USART4_H__

typedef struct GYRO{
		float AX;
		float AY;
		float AZ;
		float GX;
		float GY;
		float GZ;
		float PITCH;
		float ROLL;
		float YAW;
		float Temperature;
}GYRO;
//陀螺仪配置
void UART4_Configuration(void);

#endif
