eleboss/DJI_robomaster_car/开源参考/2组嵌入式软件/夏令营 STM32/电机推杆v1/Mylib/pwm.c

#include "main.h"

void PWM_Configuration(void)
{
	TIM_TimeBaseInitTypeDef  tim;
	TIM_OCInitTypeDef        oc;
	GPIO_InitTypeDef         gpio;
	
	RCC_APB2PeriphClockCmd(RCC_APB2Periph_GPIOA|RCC_APB2Periph_GPIOB|RCC_APB2Periph_AFIO, ENABLE);
	RCC_APB1PeriphClockCmd(RCC_APB1Periph_TIM3|RCC_APB1Periph_TIM4,ENABLE);
	
	gpio.GPIO_Pin = GPIO_Pin_6|GPIO_Pin_7;
	gpio.GPIO_Mode = GPIO_Mode_AF_PP;
	gpio.GPIO_Speed = GPIO_Speed_50MHz;
	GPIO_Init(GPIOA, &gpio);
	gpio.GPIO_Pin = GPIO_Pin_0|GPIO_Pin_1|GPIO_Pin_6|GPIO_Pin_7|GPIO_Pin_8|GPIO_Pin_9;
	GPIO_Init(GPIOB, &gpio);
	gpio.GPIO_Pin = GPIO_Pin_4|GPIO_Pin_5;
	gpio.GPIO_Mode = GPIO_Mode_Out_PP;
	GPIO_Init(GPIOA, &gpio);
	GPIO_SetBits(GPIOA, GPIO_Pin_4|GPIO_Pin_5);
	
	tim.TIM_Period=3000;
	tim.TIM_Prescaler=71;
	tim.TIM_ClockDivision=TIM_CKD_DIV1;
	tim.TIM_CounterMode=TIM_CounterMode_Up;
	TIM_TimeBaseInit(TIM4, &tim);
	tim.TIM_Period=2000;
	tim.TIM_Prescaler=0;
	TIM_TimeBaseInit(TIM3, &tim);
	
	oc.TIM_OCMode = TIM_OCMode_PWM2;
	oc.TIM_OutputState = TIM_OutputState_Enable;
	oc.TIM_OutputNState = TIM_OutputNState_Disable;
	oc.TIM_Pulse = 1520;
	oc.TIM_OCPolarity = TIM_OCPolarity_Low;
	oc.TIM_OCNPolarity = TIM_OCPolarity_High;
	oc.TIM_OCIdleState = TIM_OCIdleState_Reset;
	oc.TIM_OCNIdleState = TIM_OCIdleState_Reset;
	TIM_OC1Init(TIM3, &oc);
	TIM_OC2Init(TIM3, &oc);
	TIM_OC3Init(TIM3, &oc);
	TIM_OC4Init(TIM3, &oc);
	TIM_OC1Init(TIM4, &oc);
	TIM_OC2Init(TIM4, &oc);
	TIM_OC3Init(TIM4, &oc);
	TIM_OC4Init(TIM4, &oc);

	TIM_ARRPreloadConfig(TIM3, ENABLE);
	TIM_CtrlPWMOutputs(TIM3,ENABLE);
	TIM_Cmd(TIM3, ENABLE);
	
	TIM_ARRPreloadConfig(TIM4, ENABLE);
	TIM_CtrlPWMOutputs(TIM4,ENABLE);
	TIM_Cmd(TIM4, ENABLE);
}
