eleboss/DJI_robomaster_car/开源参考/2组嵌入式软件/夏令营 STM32/电机推杆v1/Mylib/strikeswitch.c

#include "main.h"

void SWITCH_Configuration(void)
{
	GPIO_InitTypeDef 					gpio;

	RCC_APB2PeriphClockCmd(RCC_APB2Periph_GPIOA|RCC_APB2Periph_GPIOB,ENABLE);

	gpio.GPIO_Pin = GPIO_Pin_8 | GPIO_Pin_9 | GPIO_Pin_10;
	gpio.GPIO_Speed = GPIO_Speed_50MHz;
	gpio.GPIO_Mode = GPIO_Mode_IPD;
	GPIO_Init(GPIOA,&gpio);
	
	gpio.GPIO_Pin = GPIO_Pin_15;
	GPIO_Init(GPIOB,&gpio);
}
