eleboss/DJI_robomaster_car/开源参考/2组嵌入式软件/夏令营 STM32/电机推杆v1/Mylib/usart1.c

#include "main.h"

void USART3_Configuration(void)
{
	USART_InitTypeDef usart;
	GPIO_InitTypeDef  gpio;
	NVIC_InitTypeDef  nvic;

	RCC_APB2PeriphClockCmd(RCC_APB2Periph_GPIOB, ENABLE);
	RCC_APB1PeriphClockCmd(RCC_APB1Periph_USART3,ENABLE);

	gpio.GPIO_Pin = GPIO_Pin_11;
	gpio.GPIO_Mode = GPIO_Mode_IN_FLOATING;
	GPIO_Init(GPIOB,&gpio);

	gpio.GPIO_Pin = GPIO_Pin_10;  
	gpio.GPIO_Mode = GPIO_Mode_AF_PP;
	gpio.GPIO_Speed = GPIO_Speed_50MHz;
	GPIO_Init(GPIOB,&gpio);

	USART_DeInit(USART3);
	usart.USART_BaudRate = 9600;
	usart.USART_WordLength = USART_WordLength_8b;
	usart.USART_StopBits = USART_StopBits_1;
	usart.USART_Parity = USART_Parity_No ;
	usart.USART_Mode = USART_Mode_Rx | USART_Mode_Tx;
	usart.USART_HardwareFlowControl = USART_HardwareFlowControl_None;   
	USART_Init(USART3,&usart);
	USART_Cmd(USART3,ENABLE);

	nvic.NVIC_IRQChannel = USART3_IRQn;
	nvic.NVIC_IRQChannelPreemptionPriority = 0;
	nvic.NVIC_IRQChannelSubPriority = 0;
	nvic.NVIC_IRQChannelCmd = ENABLE;
	NVIC_Init(&nvic);
}

int fputc(int ch, FILE *f)
{
    while (USART_GetFlagStatus(USART3, USART_FLAG_TC) == RESET);
    USART_SendData(USART3, (uint8_t)ch);
    return ch;
}

void USART3_IRQHandler() 
{
    if(USART_GetITStatus(USART3, USART_IT_RXNE) != RESET)
    {

    }
}
