eleboss/DJI_robomaster_car/开源参考/2组嵌入式软件/夏令营 STM32/锯条v2/Mylib/led.c

#include "main.h"

void LED_Configuration(void)
{
	GPIO_InitTypeDef gpio;   

	RCC_APB2PeriphClockCmd(RCC_APB2Periph_GPIOC , ENABLE);
	
	gpio.GPIO_Pin = GPIO_Pin_13;	
	gpio.GPIO_Mode = GPIO_Mode_Out_PP;
	gpio.GPIO_Speed = GPIO_Speed_50MHz;
	GPIO_Init(GPIOC, &gpio);

	GPIO_ResetBits(GPIOC, GPIO_Pin_13);
}
