eleboss/DJI_robomaster_car/开源参考/icra2017rm-mmc-emb-release/bsp/inc/stm32util.h

#ifndef __STM32_UTIL_H__
#define __STM32_UTIL_H__

#ifdef __cplusplus
extern "C" {
#endif

#include "platform.h"

typedef uint32_t GPIO;

#define GPIO_PIN_GRP(gpio) ((GPIO_TypeDef *)(((GPIO)(gpio)) & 0xffffff00))
#define GPIO_PIN_GRP_NUM(gpio) ( \
	(GPIO_PIN_GRP(gpio) == GPIOA) ? 0 : \
	(GPIO_PIN_GRP(gpio) == GPIOB) ? 1 : \
	(GPIO_PIN_GRP(gpio) == GPIOC) ? 2 : \
	(GPIO_PIN_GRP(gpio) == GPIOD) ? 3 : \
	(GPIO_PIN_GRP(gpio) == GPIOE) ? 4 : \
	(GPIO_PIN_GRP(gpio) == GPIOF) ? 5 : \
	(GPIO_PIN_GRP(gpio) == GPIOG) ? 6 : \
	(GPIO_PIN_GRP(gpio) == GPIOH) ? 7 : \
	(GPIO_PIN_GRP(gpio) == GPIOI) ? 8 : \
	(GPIO_PIN_GRP(gpio) == GPIOJ) ? 9 : \
	10 )
#define GPIO_PIN_NUM(gpio) (((GPIO)(gpio)) & 0x0000000f)
#define GPIO_PIN_MSK(gpio) (((uint32_t)1) << GPIO_PIN_NUM(gpio))
#define IS_VALID_GPIO_GRP(grp) IS_GPIO_ALL_PERIPH(grp)
#define IS_VALID_GPIO_PIN_NUM(pin) ((pin) <= 15)
#define IS_VALID_GPIO(gpio) (IS_VALID_GPIO_GRP(GPIO_PIN_GRP(gpio)) && IS_VALID_GPIO_PIN_NUM(GPIO_PIN_NUM(gpio)))

#define UINT32(Y) (((uint32_t)Y) & 0x0000000f)
#define GPIO_BASE(X,Y) (GPIO##X##_BASE | UINT32(Y))

#define PA0 GPIO_BASE(A,0)
#define PA1 GPIO_BASE(A,1)
#define PA2 GPIO_BASE(A,2)
#define PA3 GPIO_BASE(A,3)
#define PA4 GPIO_BASE(A,4)
#define PA5 GPIO_BASE(A,5)
#define PA6 GPIO_BASE(A,6)
#define PA7 GPIO_BASE(A,7)
#define PA8 GPIO_BASE(A,8)
#define PA9 GPIO_BASE(A,9)
#define PA10 GPIO_BASE(A,10)
#define PA11 GPIO_BASE(A,11)
#define PA12 GPIO_BASE(A,12)
#define PA13 GPIO_BASE(A,13)
#define PA14 GPIO_BASE(A,14)
#define PA15 GPIO_BASE(A,15)

#define PB0 GPIO_BASE(B,0)
#define PB1 GPIO_BASE(B,1)
#define PB2 GPIO_BASE(B,2)
#define PB3 GPIO_BASE(B,3)
#define PB4 GPIO_BASE(B,4)
#define PB5 GPIO_BASE(B,5)
#define PB6 GPIO_BASE(B,6)
#define PB7 GPIO_BASE(B,7)
#define PB8 GPIO_BASE(B,8)
#define PB9 GPIO_BASE(B,9)
#define PB10 GPIO_BASE(B,10)
#define PB11 GPIO_BASE(B,11)
#define PB12 GPIO_BASE(B,12)
#define PB13 GPIO_BASE(B,13)
#define PB14 GPIO_BASE(B,14)
#define PB15 GPIO_BASE(B,15)

#define PC0 GPIO_BASE(C,0)
#define PC1 GPIO_BASE(C,1)
#define PC2 GPIO_BASE(C,2)
#define PC3 GPIO_BASE(C,3)
#define PC4 GPIO_BASE(C,4)
#define PC5 GPIO_BASE(C,5)
#define PC6 GPIO_BASE(C,6)
#define PC7 GPIO_BASE(C,7)
#define PC8 GPIO_BASE(C,8)
#define PC9 GPIO_BASE(C,9)
#define PC10 GPIO_BASE(C,10)
#define PC11 GPIO_BASE(C,11)
#define PC12 GPIO_BASE(C,12)
#define PC13 GPIO_BASE(C,13)
#define PC14 GPIO_BASE(C,14)
#define PC15 GPIO_BASE(C,15)

#define PD0 GPIO_BASE(D,0)
#define PD1 GPIO_BASE(D,1)
#define PD2 GPIO_BASE(D,2)
#define PD3 GPIO_BASE(D,3)
#define PD4 GPIO_BASE(D,4)
#define PD5 GPIO_BASE(D,5)
#define PD6 GPIO_BASE(D,6)
#define PD7 GPIO_BASE(D,7)
#define PD8 GPIO_BASE(D,8)
#define PD9 GPIO_BASE(D,9)
#define PD10 GPIO_BASE(D,10)
#define PD11 GPIO_BASE(D,11)
#define PD12 GPIO_BASE(D,12)
#define PD13 GPIO_BASE(D,13)
#define PD14 GPIO_BASE(D,14)
#define PD15 GPIO_BASE(D,15)

#define PE0 GPIO_BASE(E,0)
#define PE1 GPIO_BASE(E,1)
#define PE2 GPIO_BASE(E,2)
#define PE3 GPIO_BASE(E,3)
#define PE4 GPIO_BASE(E,4)
#define PE5 GPIO_BASE(E,5)
#define PE6 GPIO_BASE(E,6)
#define PE7 GPIO_BASE(E,7)
#define PE8 GPIO_BASE(E,8)
#define PE9 GPIO_BASE(E,9)
#define PE10 GPIO_BASE(E,10)
#define PE11 GPIO_BASE(E,11)
#define PE12 GPIO_BASE(E,12)
#define PE13 GPIO_BASE(E,13)
#define PE14 GPIO_BASE(E,14)
#define PE15 GPIO_BASE(E,15)

#define PF0 GPIO_BASE(F,0)
#define PF1 GPIO_BASE(F,1)
#define PF2 GPIO_BASE(F,2)
#define PF3 GPIO_BASE(F,3)
#define PF4 GPIO_BASE(F,4)
#define PF5 GPIO_BASE(F,5)
#define PF6 GPIO_BASE(F,6)
#define PF7 GPIO_BASE(F,7)
#define PF8 GPIO_BASE(F,8)
#define PF9 GPIO_BASE(F,9)
#define PF10 GPIO_BASE(F,10)
#define PF11 GPIO_BASE(F,11)
#define PF12 GPIO_BASE(F,12)
#define PF13 GPIO_BASE(F,13)
#define PF14 GPIO_BASE(F,14)
#define PF15 GPIO_BASE(F,15)

#define PG0 GPIO_BASE(G,0)
#define PG1 GPIO_BASE(G,1)
#define PG2 GPIO_BASE(G,2)
#define PG3 GPIO_BASE(G,3)
#define PG4 GPIO_BASE(G,4)
#define PG5 GPIO_BASE(G,5)
#define PG6 GPIO_BASE(G,6)
#define PG7 GPIO_BASE(G,7)
#define PG8 GPIO_BASE(G,8)
#define PG9 GPIO_BASE(G,9)
#define PG10 GPIO_BASE(G,10)
#define PG11 GPIO_BASE(G,11)
#define PG12 GPIO_BASE(G,12)
#define PG13 GPIO_BASE(G,13)
#define PG14 GPIO_BASE(G,14)
#define PG15 GPIO_BASE(G,15)

#define PH0 GPIO_BASE(H,0)
#define PH1 GPIO_BASE(H,1)
#define PH2 GPIO_BASE(H,2)
#define PH3 GPIO_BASE(H,3)
#define PH4 GPIO_BASE(H,4)
#define PH5 GPIO_BASE(H,5)
#define PH6 GPIO_BASE(H,6)
#define PH7 GPIO_BASE(H,7)
#define PH8 GPIO_BASE(H,8)
#define PH9 GPIO_BASE(H,9)
#define PH10 GPIO_BASE(H,10)
#define PH11 GPIO_BASE(H,11)
#define PH12 GPIO_BASE(H,12)
#define PH13 GPIO_BASE(H,13)
#define PH14 GPIO_BASE(H,14)
#define PH15 GPIO_BASE(H,15)

#define PI0 GPIO_BASE(I,0)
#define PI1 GPIO_BASE(I,1)
#define PI2 GPIO_BASE(I,2)
#define PI3 GPIO_BASE(I,3)
#define PI4 GPIO_BASE(I,4)
#define PI5 GPIO_BASE(I,5)
#define PI6 GPIO_BASE(I,6)
#define PI7 GPIO_BASE(I,7)
#define PI8 GPIO_BASE(I,8)
#define PI9 GPIO_BASE(I,9)
#define PI10 GPIO_BASE(I,10)
#define PI11 GPIO_BASE(I,11)
#define PI12 GPIO_BASE(I,12)
#define PI13 GPIO_BASE(I,13)
#define PI14 GPIO_BASE(I,14)
#define PI15 GPIO_BASE(I,15)

#define PJ0 GPIO_BASE(J,0)
#define PJ1 GPIO_BASE(J,1)
#define PJ2 GPIO_BASE(J,2)
#define PJ3 GPIO_BASE(J,3)
#define PJ4 GPIO_BASE(J,4)
#define PJ5 GPIO_BASE(J,5)
#define PJ6 GPIO_BASE(J,6)
#define PJ7 GPIO_BASE(J,7)
#define PJ8 GPIO_BASE(J,8)
#define PJ9 GPIO_BASE(J,9)
#define PJ10 GPIO_BASE(J,10)
#define PJ11 GPIO_BASE(J,11)
#define PJ12 GPIO_BASE(J,12)
#define PJ13 GPIO_BASE(J,13)
#define PJ14 GPIO_BASE(J,14)
#define PJ15 GPIO_BASE(J,15)

#define PK0 GPIO_BASE(K,0)
#define PK1 GPIO_BASE(K,1)
#define PK2 GPIO_BASE(K,2)
#define PK3 GPIO_BASE(K,3)
#define PK4 GPIO_BASE(K,4)
#define PK5 GPIO_BASE(K,5)
#define PK6 GPIO_BASE(K,6)
#define PK7 GPIO_BASE(K,7)
#define PK8 GPIO_BASE(K,8)
#define PK9 GPIO_BASE(K,9)
#define PK10 GPIO_BASE(K,10)
#define PK11 GPIO_BASE(K,11)
#define PK12 GPIO_BASE(K,12)
#define PK13 GPIO_BASE(K,13)
#define PK14 GPIO_BASE(K,14)
#define PK15 GPIO_BASE(K,15)

#define GPIO_SET(gpio) GPIO_SetBits(GPIO_PIN_GRP(gpio), GPIO_PIN_MSK(gpio))
#define GPIO_RST(gpio) GPIO_ResetBits(GPIO_PIN_GRP(gpio), GPIO_PIN_MSK(gpio))
#define GPIO_TOG(gpio) GPIO_ToggleBits(GPIO_PIN_GRP(gpio), GPIO_PIN_MSK(gpio))
#define GPIO_READ_IN(gpio) GPIO_ReadInputDataBit(GPIO_PIN_GRP(gpio), GPIO_PIN_MSK(gpio))
#define GPIO_READ_OUT(gpio) GPIO_ReadOutputDataBit(GPIO_PIN_GRP(gpio), GPIO_PIN_MSK(gpio))
#define GPIO_WRITE(gpio,v) GPIO_WriteBit(GPIO_PIN_GRP(gpio), GPIO_PIN_MSK(gpio), (v) > 0 ? Bit_SET : Bit_RESET)

#define RCC_CLK_ENABLE(BUS,NAME) RCC_##BUS##PeriphClockCmd(RCC_##BUS##Periph_##NAME, ENABLE)

#define RETURN_ZERO_IF_ASSERT_FAILED(FLAG) if(!(FLAG)) return 0
	
#define GPIO_AF(PIN,TO) do { \
	GPIO_Af(PIN,GPIO_AF_##TO); \
} while(0)

// TO DO
#define GPIO_BIND(PIN,TO) do { \
	GPIO_Af(PIN,GPIO_AF_##TO); \
} while(0)

#define USART_BIND(RX,TX,USART,BR,WL,PR,SB,FC) do { \
	if (IS_VALID_GPIO(RX) && IS_VALID_GPIO(TX)) { \
		GPIO_Af(RX,GPIO_AF_##USART); \
		GPIO_Af(TX,GPIO_AF_##USART); \
		USART_Config(USART, ' ', BR, WL, PR, SB, FC); \
	} else if (IS_VALID_GPIO(RX)) { \
		GPIO_Af(RX,GPIO_AF_##USART); \
		USART_Config(USART, 'r', BR, WL, PR, SB, FC); \
	} else if (IS_VALID_GPIO(TX)) { \
		GPIO_Af(TX,GPIO_AF_##USART); \
		USART_Config(USART, 't', BR, WL, PR, SB, FC); \
	} \
} while(0)

#define PWM_BIND(A,B,C,D,TIM,PS,PD,PW) do { \
	uint8_t channel = 0; \
	if (IS_VALID_GPIO(A)) { \
		GPIO_Af(A, GPIO_AF_##TIM); \
		channel |= 0x01; \
	} \
	if (IS_VALID_GPIO(B)) { \
		GPIO_Af(B, GPIO_AF_##TIM); \
		channel |= 0x02; \
	} \
	if (IS_VALID_GPIO(C)) { \
		GPIO_Af(C, GPIO_AF_##TIM); \
		channel |= 0x04; \
	} \
	if (IS_VALID_GPIO(D)) { \
		GPIO_Af(D, GPIO_AF_##TIM); \
		channel |= 0x08; \
	} \
	TIM_Config(TIM, PS, TIM_CounterMode_Up, PD, TIM_CKD_DIV1, 0); \
	TIM_OC_Config(TIM, channel, TIM_OCMode_PWM2, PW); \
	TIM_ARRPreloadConfig(TIM, ENABLE); \
} while(0)

#define SPI_BIND(NSSPIN,SCKPIN,MISOPIN,MOSIPIN,SPIX,MODE,DIR,DS,CPOL,SPHA,NSS,PS,FB,CRCP) do { \
	if (IS_VALID_GPIO(NSSPIN)) { \
		GPIO_Af(NSSPIN, GPIO_AF_##SPIX); \
	} \
	if (IS_VALID_GPIO(SCKPIN)) { \
		GPIO_Af(SCKPIN, GPIO_AF_##SPIX); \
	} \
	if (IS_VALID_GPIO(MISOPIN)) { \
		GPIO_Af(MISOPIN, GPIO_AF_##SPIX); \
	} \
	if (IS_VALID_GPIO(MOSIPIN)) { \
		GPIO_Af(MOSIPIN, GPIO_AF_##SPIX); \
	} \
	SPI_Config(SPIX, MODE, DIR, DS, CPOL, SPHA, NSS, PS, FB, CRCP); \
} while (0)

#define IRQ(NAME) NAME##_IRQn
#define IRQ_HANDLER(NAME) NAME##_IRQHandler

#define EXTI_LINE_NUM 16

typedef void (*ExtiHandler)(uint8_t line);

extern ExtiHandler extiHandlers[EXTI_LINE_NUM];

void EXTI_SetHandler(uint8_t num, ExtiHandler handler);

// For private use only
#define EXIT_N_IRQ_HANDLER(N) \
do { \
	if (EXTI_GetITStatus(EXTI_Line##N) != RESET) { \
		EXTI_ClearITPendingBit(EXTI_Line##N); \
		EXTI_ClearFlag(EXTI_Line##N); \
		if (extiHandlers[N]) extiHandlers[N](N); \
	} \
} while (0)

GPIO_TypeDef* GPIO_GetGroup(GPIO gpio);
uint16_t GPIO_GetMask(GPIO gpio);
uint8_t GPIO_GetNum(GPIO gpio);

uint8_t GPIO_ReadIn(GPIO gpio);
uint8_t GPIO_ReadOut(GPIO gpio);
void GPIO_WriteOut(GPIO gpio, uint8_t newState);
void GPIO_Set(GPIO gpio);
void GPIO_Rst(GPIO gpio);
void GPIO_Tog(GPIO gpio);

void GPIO_Config(GPIO gpio, GPIOMode_TypeDef mode, GPIOSpeed_TypeDef speed, GPIOOType_TypeDef otype, GPIOPuPd_TypeDef pupd);
void GPIO_In(GPIO gpio);
void GPIO_Out(GPIO gpio);
void GPIO_Af(GPIO gpio, u8 af);
void USART_Config(USART_TypeDef* usartx, s8 mode, u32 br, u8 wl, s8 parity, float sb, s8 fc);
void USART_Bind(GPIO rx, GPIO tx, USART_TypeDef* usartx, u32 br, u8 wl, s8 parity, float sb, s8 fc);
void TIM_Config(TIM_TypeDef* timx, u16 ps, u16 mode, u32 period, u16 div, u8 re);
void Encoder_Bind(GPIO A, GPIO B, TIM_TypeDef* timx, u16 mode, u16 p1, u16 p2);
void TIM_OC_Config(TIM_TypeDef* timx, u8 channel, u16 mode, u32 pulse);
void PWM_Bind(GPIO A, GPIO B, GPIO C, GPIO D, TIM_TypeDef* timx, u16 ps, u32 pd, u32 pw);
void NVIC_Config(u8 channel, u8 pre, u8 sub);
void CAN_Config(CAN_TypeDef* canx, u16 ps, u8 mode, u8 sjw, u8 bs1, u8 bs2);
void CAN_Filter_Config(u16 id_h, u16 id_l, u16 msk_h, u16 msk_l, u16 fifo, u8 num);
void DMA_Config(DMA_Stream_TypeDef* DMAy_Streamx, u32 channel, u32 pba, u32 mba, u32 dir, u32 bs);
void EXTI_Config(u32 line, EXTIMode_TypeDef mode, EXTITrigger_TypeDef trigger);
void EXTI_Bind(GPIO gpio, uint8_t pre_priority, uint8_t sub_priority, EXTITrigger_TypeDef trigger, ExtiHandler handler);
void SPI_Config(SPI_TypeDef* spix, uint16_t mode, uint16_t dir, uint16_t ds, uint16_t cpol, uint16_t cpha, uint16_t nss, uint16_t ps, uint16_t fb, uint16_t crcp);
void SPI_Bind(GPIO nssPin, GPIO sckPin, GPIO misoPin, GPIO mosiPin, SPI_TypeDef* spix, uint16_t mode, uint16_t dir, uint16_t ds, uint16_t cpol, uint16_t cpha, uint16_t nss, uint16_t ps, uint16_t fb, uint16_t crcp);
uint8_t SPI_TxRxByte(SPI_TypeDef* spix, uint8_t txData, uint8_t* rxData, uint32_t timeout);
uint32_t SPI_TxRx(SPI_TypeDef* spix, const uint8_t* txData, uint8_t* rxData, uint32_t len, uint32_t timeout);

#ifdef __cplusplus
}
#endif

#endif
