eleboss/DJI_robomaster_car/robomaster2017_challenge contest/bsp/src/delay.c

#include "main.h"

void Delay_Ms(unsigned int t)
{
	int i;
	for( i=0;i<t;i++)
	{
		int a=42000;
		while(a--);
	}
}

void Delay_Us(unsigned int t)
{
	int i;
	for( i=0;i<t;i++)
	{
		int a=40;
		while(a--);
	}
}
