eleboss/DJI_robomaster_car/(commit log)

2017-07-10 原理图和SW文件
    [holder.SLDPRT, 卡件.SLDPRT, 比赛台子-3D printer.SLDPRT, 比赛台子-新.SLDPRT, 轴.SLDPRT]
2017-07-15 改了一下文件夹顺序
2017-07-15 更新了solidworks文件
    [holder.SLDPRT, 卡件.SLDPRT]
2017-07-21 文件修改-底层基本写完
    [STM32F427.cfg, 上升横杆.SLDPRT, 与57步进电机相连的板.SLDPRT, 与BK相连的杆.SLDPRT, 与BK相连的竖杆.SLDPRT, 与BK相连的连接片.SLDPRT, 与上升电机连接片.SLDPRT, 与后轮马达相连杆.SLDPRT]
2017-07-23 蓝牙修改PID
2017-08-03 比赛结束，暂时先不修改了
    超声波和输入捕获暂时还不能用
